kachurovskiy/modulathe/v2/freecad/Toolpost60.FCStd

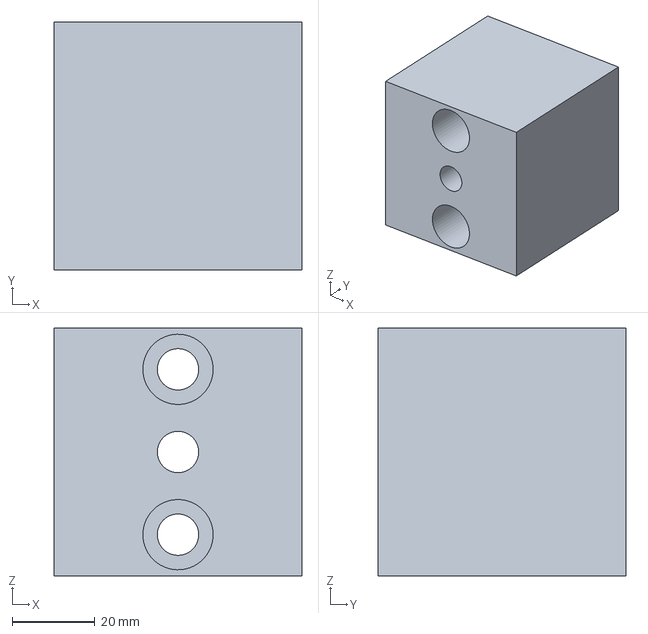
[picture p1: CAD file, 2025-09-17]
v2/freecad/Toolpost60.FCStd
60.0 x 60.0 x 60.0 mm
