kachurovskiy/modulathe/v2/step/MiddlePlateGuard2.step

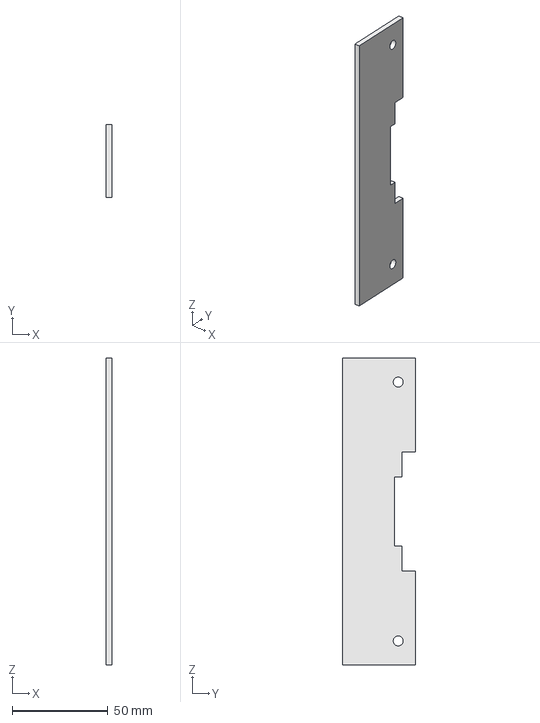
[picture p2: CAD file, 2025-09-17]
v2/step/MiddlePlateGuard2.step
3.00 x 38.0 x 160.0 mm
