kachurovskiy/modulathe/v2/freecad/DFU1605Nut.FCStd

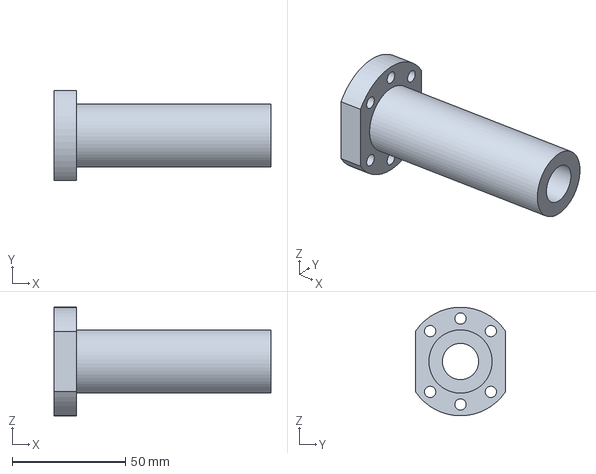
[picture p3: CAD file, 2025-09-17]
v2/freecad/DFU1605Nut.FCStd
96.0 x 40.0 x 48.0 mm
