kachurovskiy/modulathe/v2/step/Handwheels-Mount.step

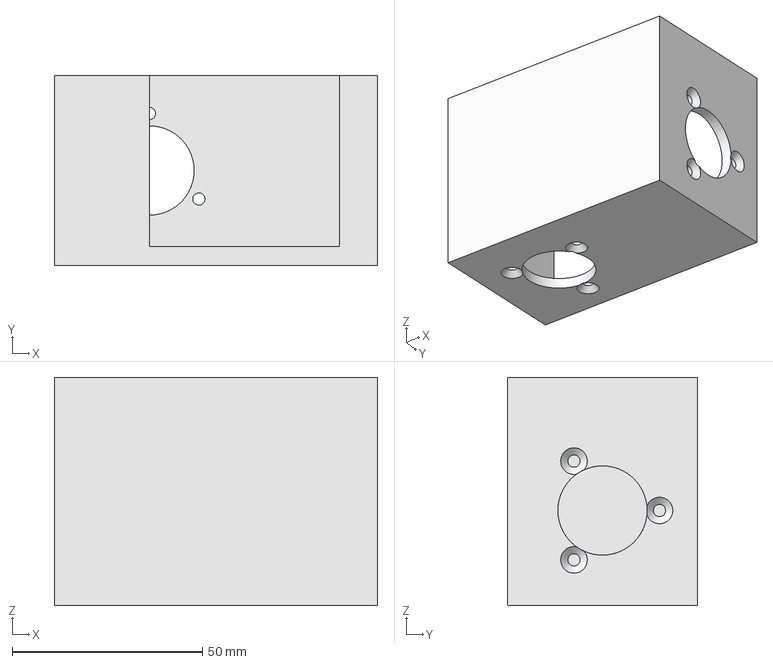
[picture p4: CAD file, 2025-09-17]
v2/step/Handwheels-Mount.step
85.0 x 50.0 x 60.0 mm
