kachurovskiy/modulathe/v2/freecad/3210B-2RS.FCStd

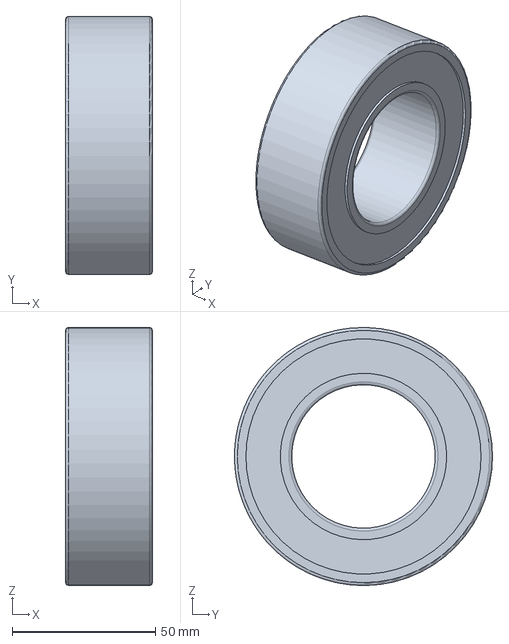
[picture p5: CAD file, 2025-09-17]
v2/freecad/3210B-2RS.FCStd
30.2 x 90.0 x 90.0 mm
