kachurovskiy/modulathe/v2/step/Motor1100BeltCover.step

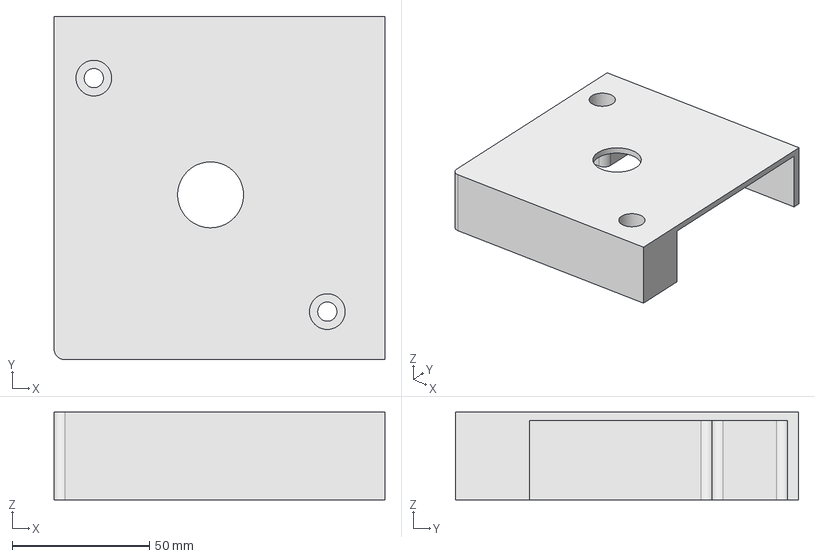
[picture p6: CAD file, 2025-09-17]
v2/step/Motor1100BeltCover.step
120.5 x 125.0 x 32.0 mm
