kachurovskiy/modulathe/v2/freecad/H5Mount.FCStd

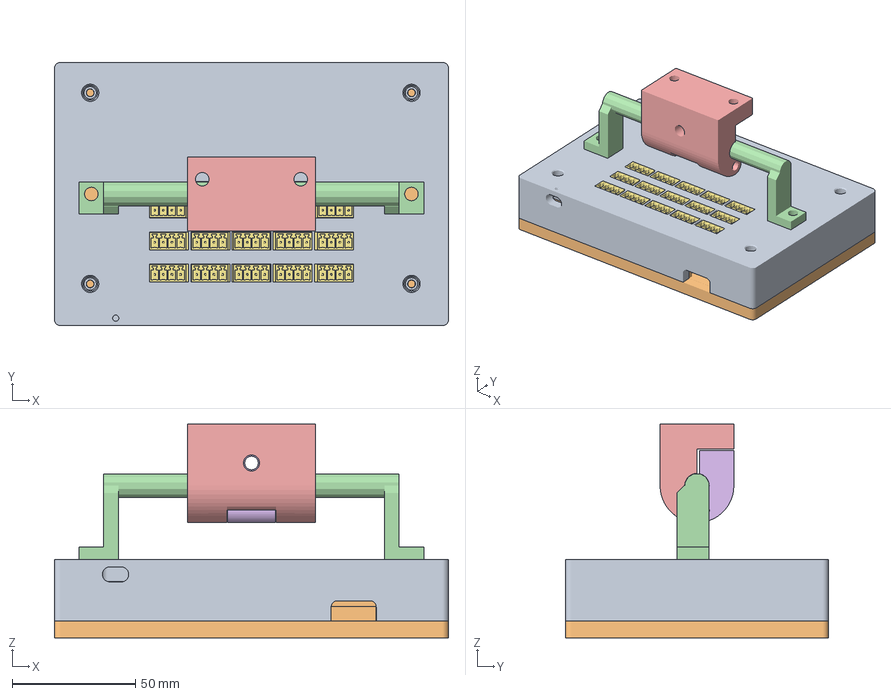
[picture p7: CAD file, 2025-09-17]
v2/freecad/H5Mount.FCStd
160.0 x 107.0 x 86.8 mm
h5case
NX8048P050-011C
esp32-wroom-1
h5handle
h5mount1
h5mount2
pcb
