kachurovskiy/modulathe/v2/step/MiddlePlateBellow2.step

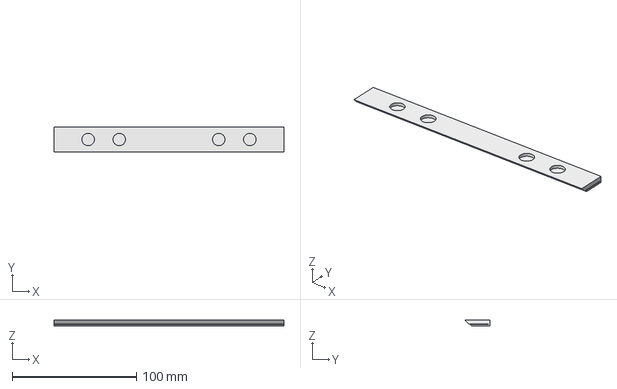
[picture p8: CAD file, 2025-09-17]
v2/step/MiddlePlateBellow2.step
185.0 x 20.0 x 4.50 mm
