kachurovskiy/modulathe/v2/freecad/Tailstock100.FCStd

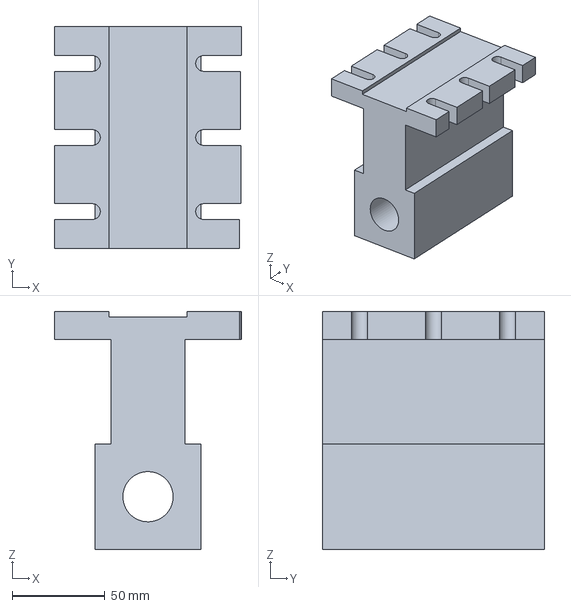
[picture p9: CAD file, 2025-09-17]
v2/freecad/Tailstock100.FCStd
101.0 x 120.0 x 128.5 mm
