kachurovskiy/modulathe/v2/step/Handwheels-Handwheel.step

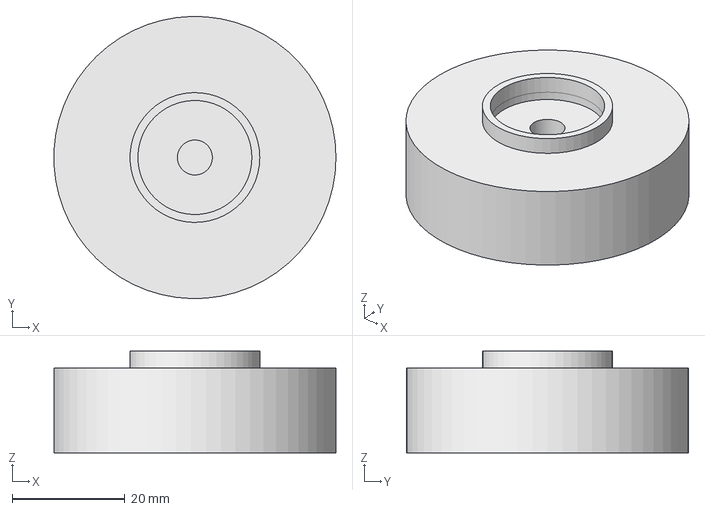
[picture p10: CAD file, 2025-09-17]
v2/step/Handwheels-Handwheel.step
50.0 x 50.0 x 18.0 mm
