kachurovskiy/modulathe/v2/freecad/Handwheels.FCStd

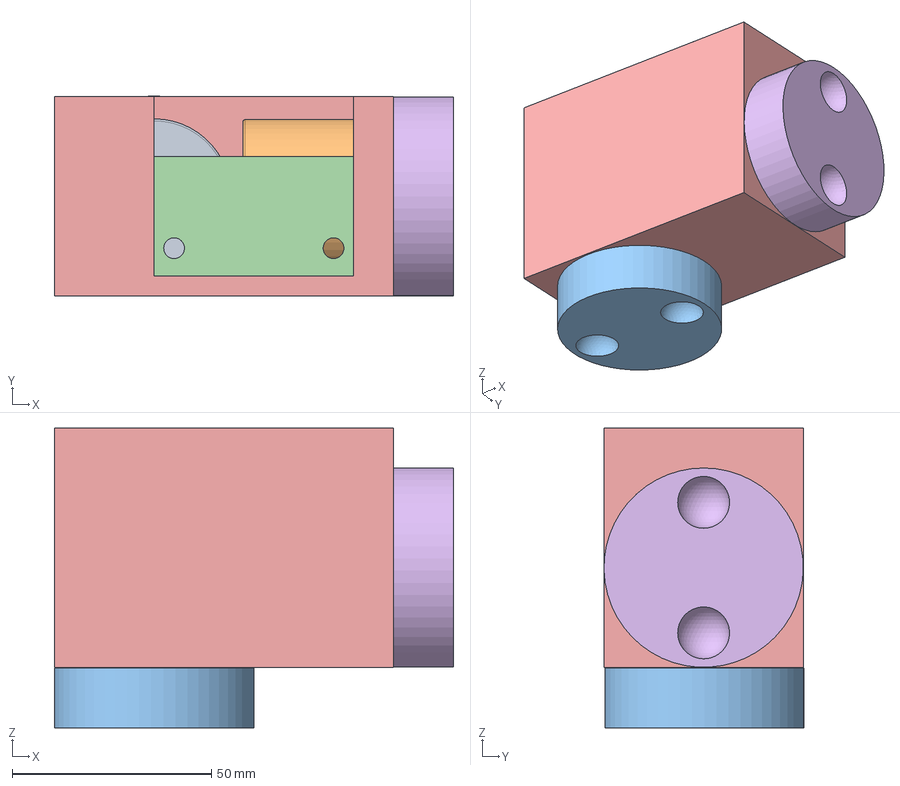
[picture p11: CAD file, 2025-09-17]
v2/freecad/Handwheels.FCStd
100.1 x 50.2 x 75.2 mm
Encoder
Encoder001
Handwheel
Base
Mount
Handwheel001
