kachurovskiy/modulathe/v2/step/MiddlePlateBellow3.step

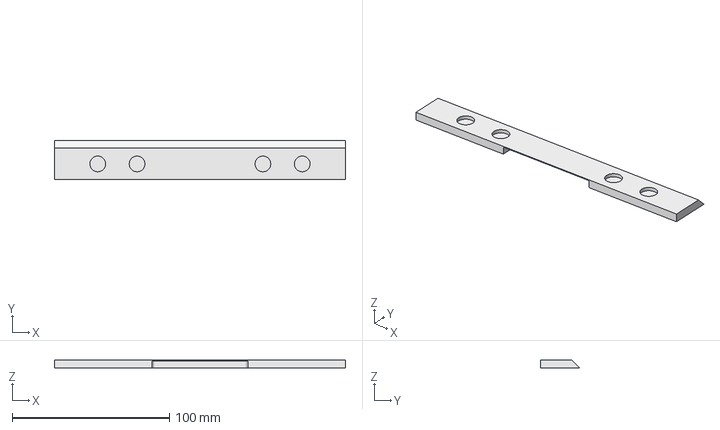
[picture p12: CAD file, 2025-09-17]
v2/step/MiddlePlateBellow3.step
185.0 x 25.0 x 5.00 mm
