kachurovskiy/modulathe/v2/freecad/DSG16H.FCStd

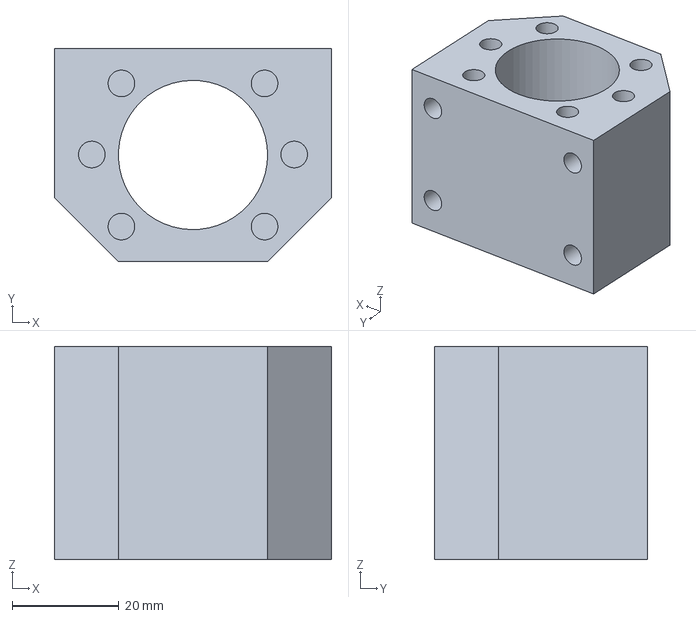
[picture p13: CAD file, 2025-09-17]
v2/freecad/DSG16H.FCStd
52.0 x 40.0 x 40.0 mm
