kachurovskiy/modulathe/v2/freecad/EncoderBelt6GT3.FCStd

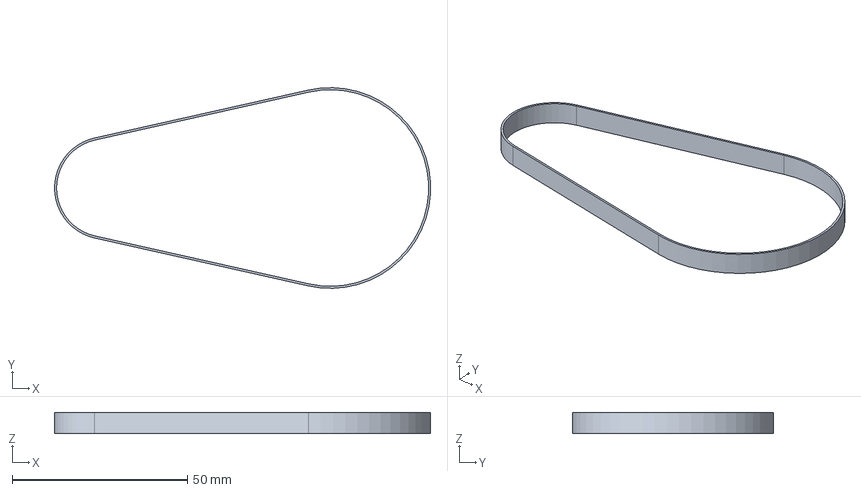
[picture p14: CAD file, 2025-09-17]
v2/freecad/EncoderBelt6GT3.FCStd
107.1 x 57.2 x 6.00 mm
