kachurovskiy/modulathe/v2/step/CabinetLid.step

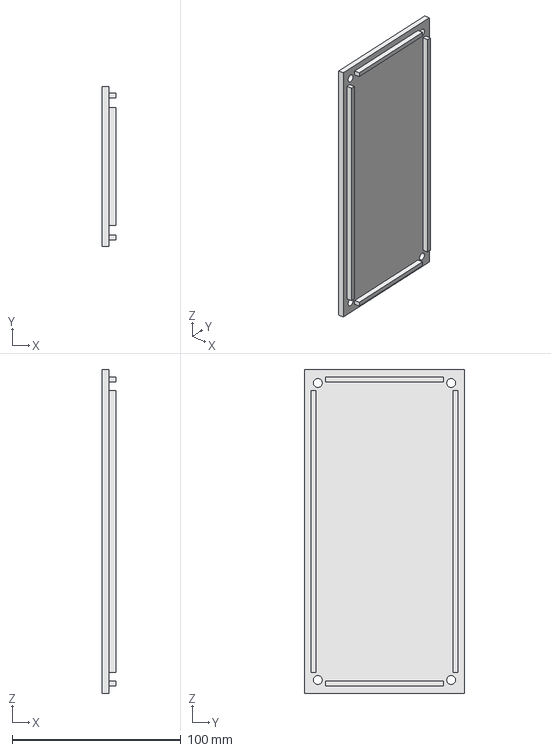
[picture p15: CAD file, 2025-09-17]
v2/step/CabinetLid.step
8.00 x 95.0 x 192.0 mm
