kachurovskiy/modulathe/v2/freecad/3209B-2RS.FCStd

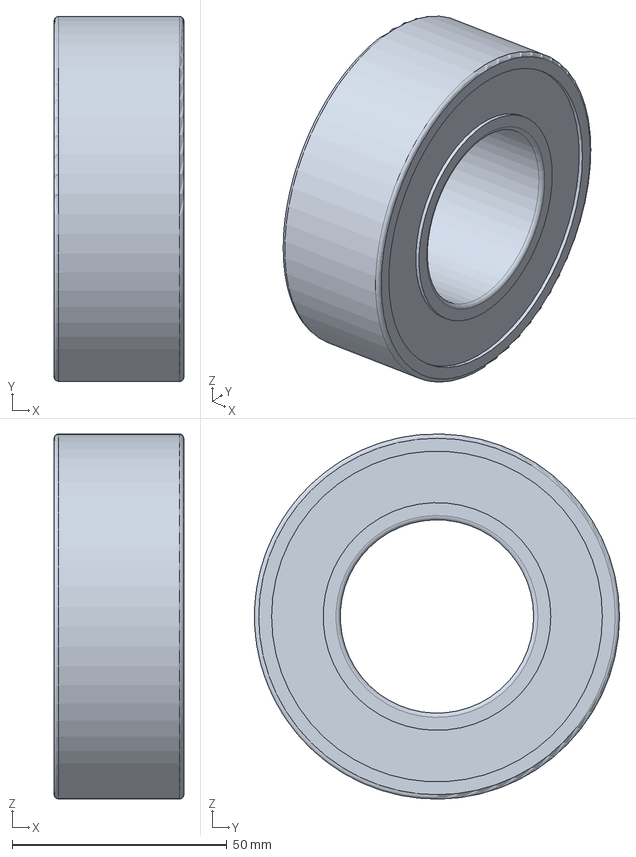
[picture p16: CAD file, 2025-09-17]
v2/freecad/3209B-2RS.FCStd
30.2 x 85.0 x 85.0 mm
