kachurovskiy/modulathe/v2/step/TopPlateGuardShort1.step

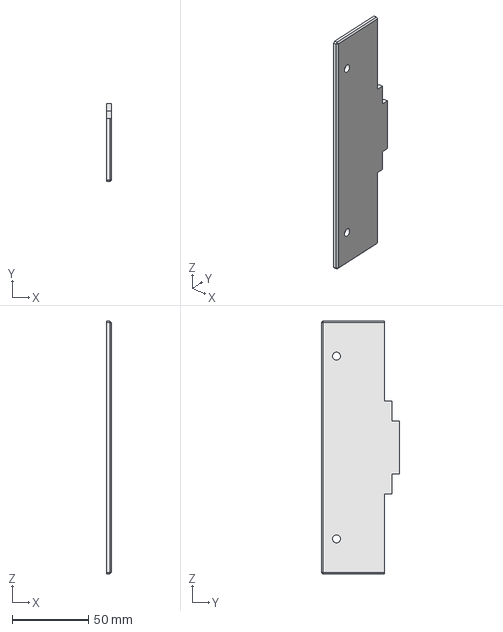
[picture p17: CAD file, 2025-09-17]
v2/step/TopPlateGuardShort1.step
3.00 x 51.5 x 166.0 mm
