kachurovskiy/modulathe/v2/freecad/HGH20CA.FCStd

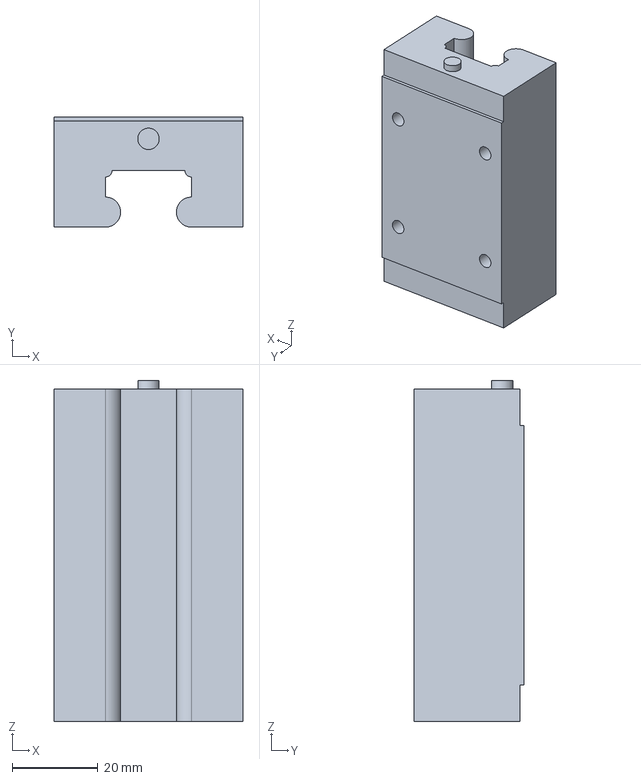
[picture p18: CAD file, 2025-09-17]
v2/freecad/HGH20CA.FCStd
44.0 x 25.7 x 79.5 mm
