kachurovskiy/modulathe/v2/step/MotorPulley30GT3.step

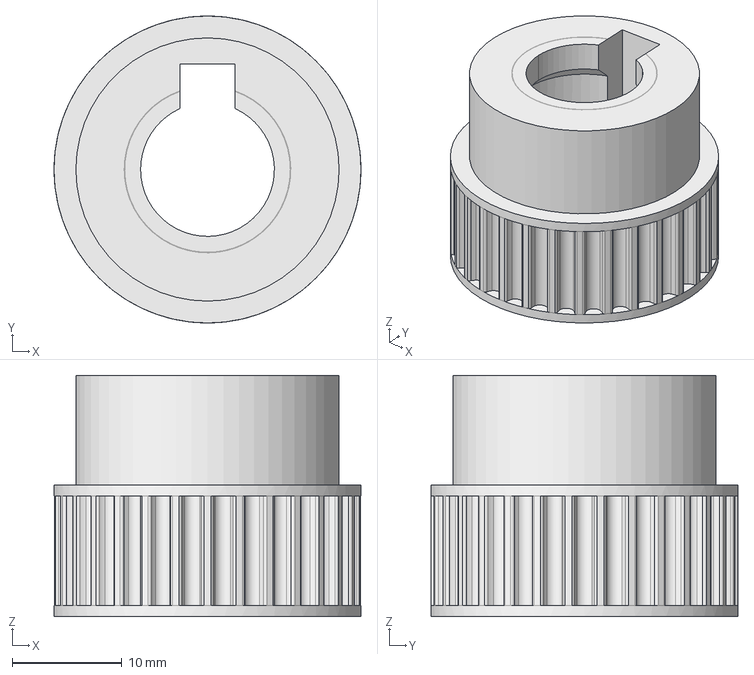
[picture p19: CAD file, 2025-09-17]
v2/step/MotorPulley30GT3.step
28.0 x 28.0 x 22.0 mm
