kachurovskiy/modulathe/v2/freecad/Track30-400.FCStd

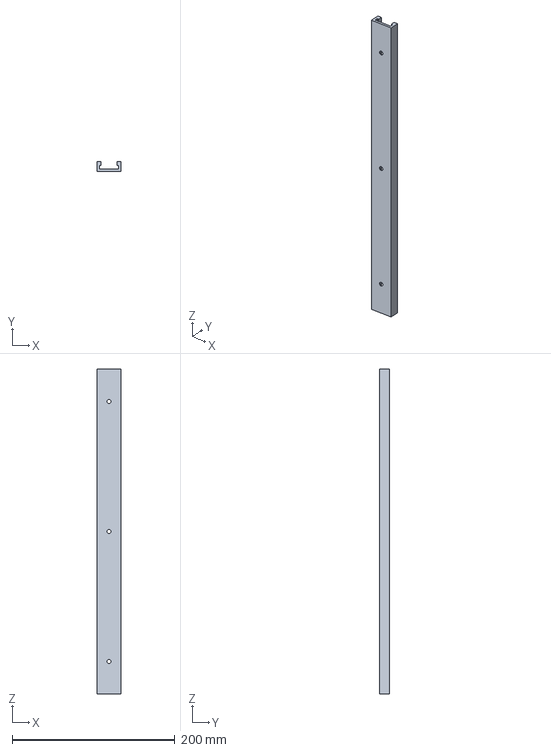
[picture p20: CAD file, 2025-09-17]
v2/freecad/Track30-400.FCStd
30.0 x 12.8 x 400.0 mm
