kachurovskiy/modulathe/v2/step/EncoderMount.step

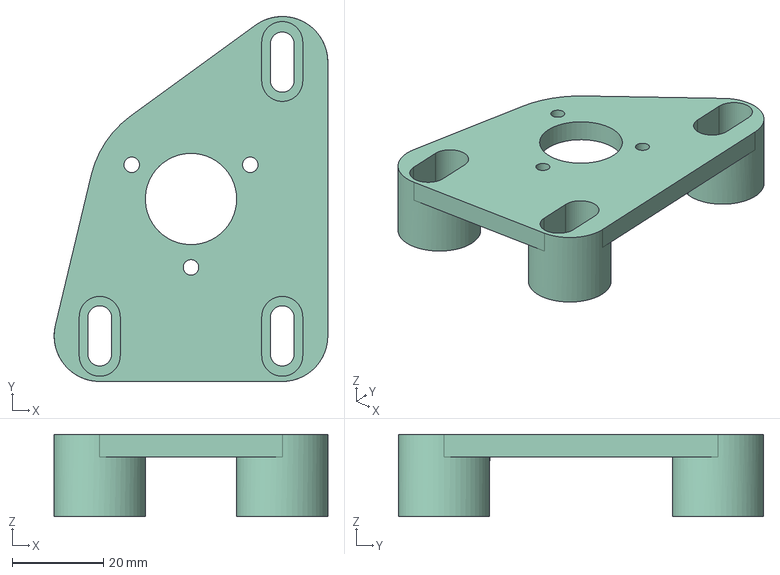
[picture p21: CAD file, 2025-09-17]
v2/step/EncoderMount.step
60.0 x 80.0 x 18.0 mm
