kachurovskiy/modulathe/v2/freecad/Coupler25-20-8-10.FCStd

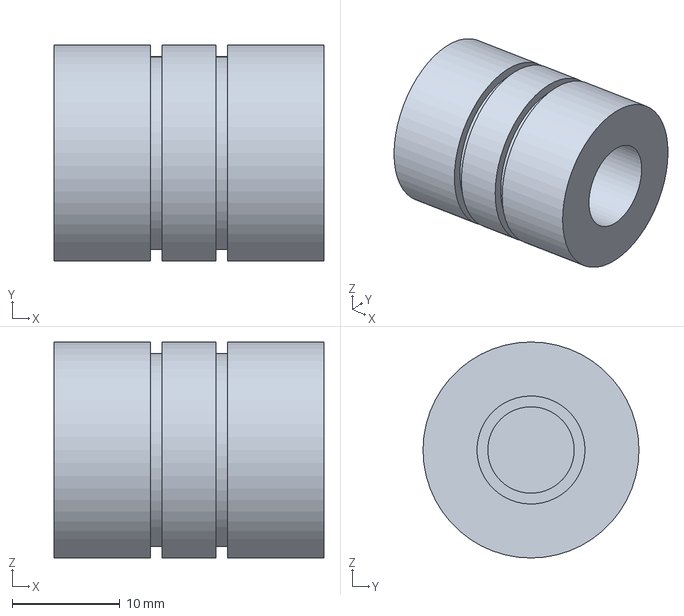
[picture p22: CAD file, 2025-09-17]
v2/freecad/Coupler25-20-8-10.FCStd
25.0 x 20.0 x 20.0 mm
