kachurovskiy/modulathe/v2/freecad/HGR15-300.FCStd

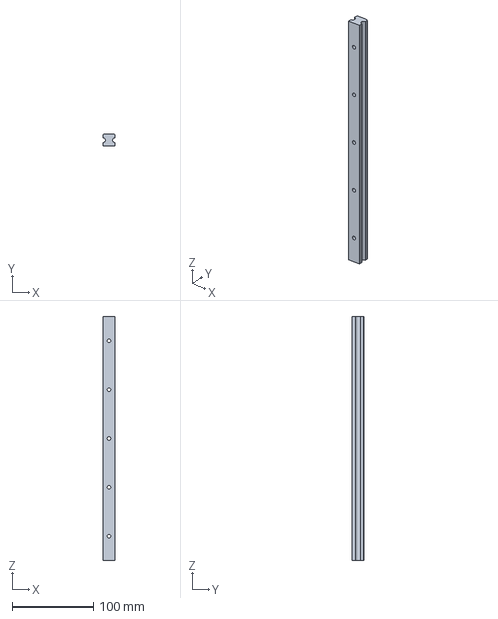
[picture p23: CAD file, 2025-09-17]
v2/freecad/HGR15-300.FCStd
15.0 x 15.0 x 300.0 mm
