kachurovskiy/modulathe/v2/step/H5Mount-h5mount1.step

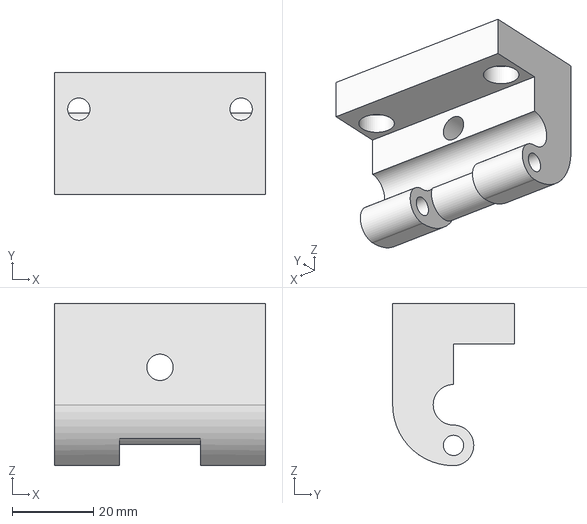
[picture p24: CAD file, 2025-09-17]
v2/step/H5Mount-h5mount1.step
52.0 x 30.0 x 40.0 mm
