kachurovskiy/modulathe/v2/freecad/BF12.FCStd

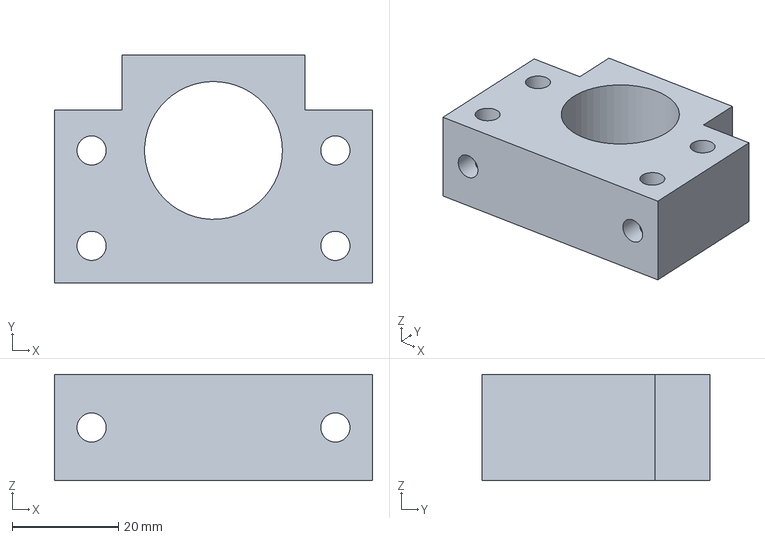
[picture p25: CAD file, 2025-09-17]
v2/freecad/BF12.FCStd
60.0 x 43.0 x 20.0 mm
