kachurovskiy/modulathe/v2/step/Handwheels-Base.step

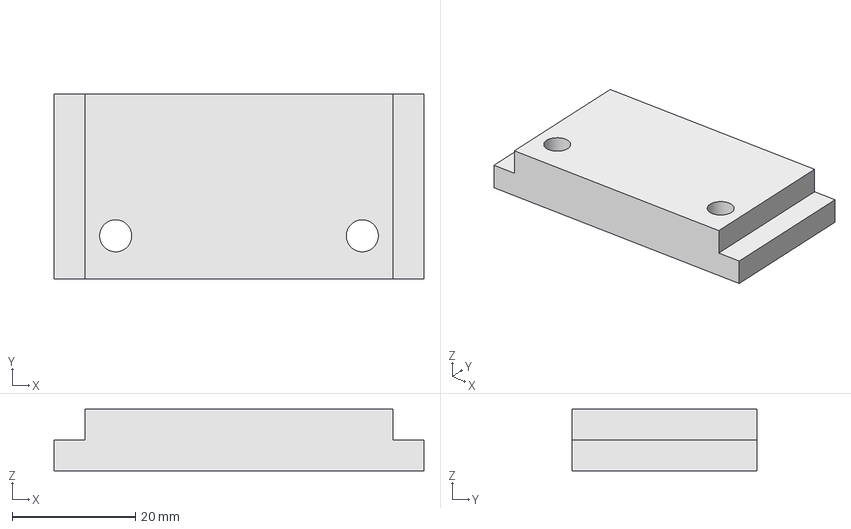
[picture p26: CAD file, 2025-09-17]
v2/step/Handwheels-Base.step
60.0 x 30.0 x 10.0 mm
