kachurovskiy/modulathe/v2/freecad/DFU1605-600.FCStd

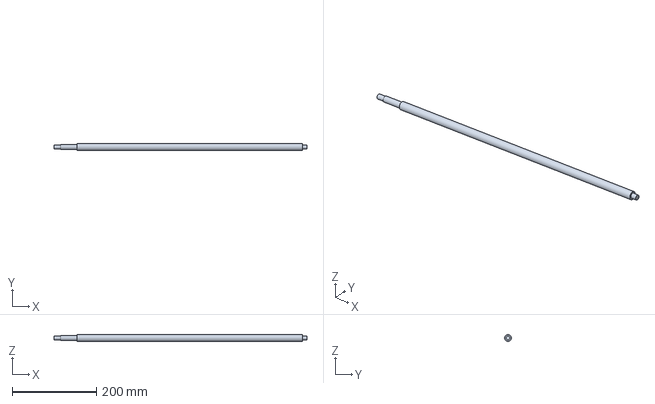
[picture p27: CAD file, 2025-09-17]
v2/freecad/DFU1605-600.FCStd
600.0 x 16.0 x 16.0 mm
