kachurovskiy/modulathe/v2/step/H5Mount-h5handle.step

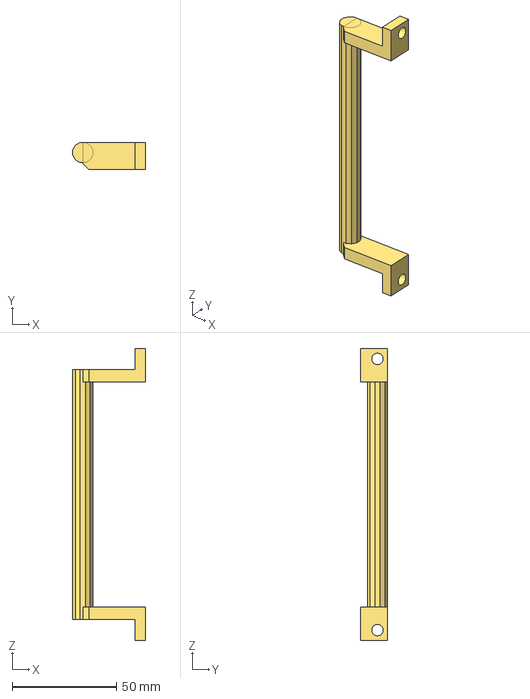
[picture p28: CAD file, 2025-09-17]
v2/step/H5Mount-h5handle.step
34.8 x 13.0 x 140.0 mm
