kachurovskiy/modulathe/v2/freecad/HGR20-600.FCStd

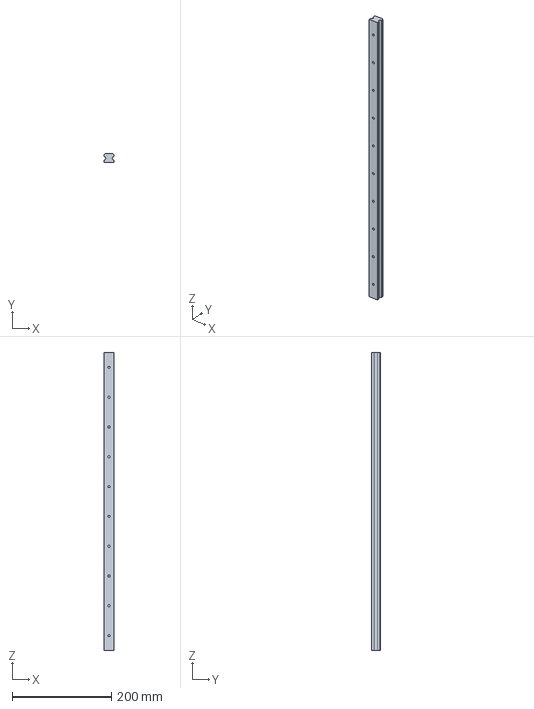
[picture p29: CAD file, 2025-09-17]
v2/freecad/HGR20-600.FCStd
20.0 x 17.5 x 600.0 mm
