kachurovskiy/modulathe/v2/step/H5Mount-h5mount2.step

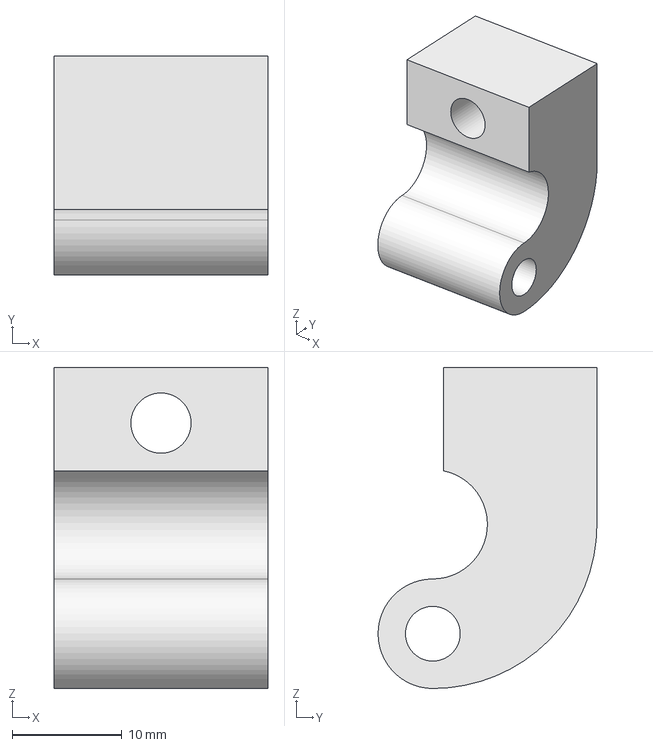
[picture p30: CAD file, 2025-09-17]
v2/step/H5Mount-h5mount2.step
19.5 x 20.0 x 29.3 mm
