kachurovskiy/modulathe/v2/freecad/BallNut1204.FCStd

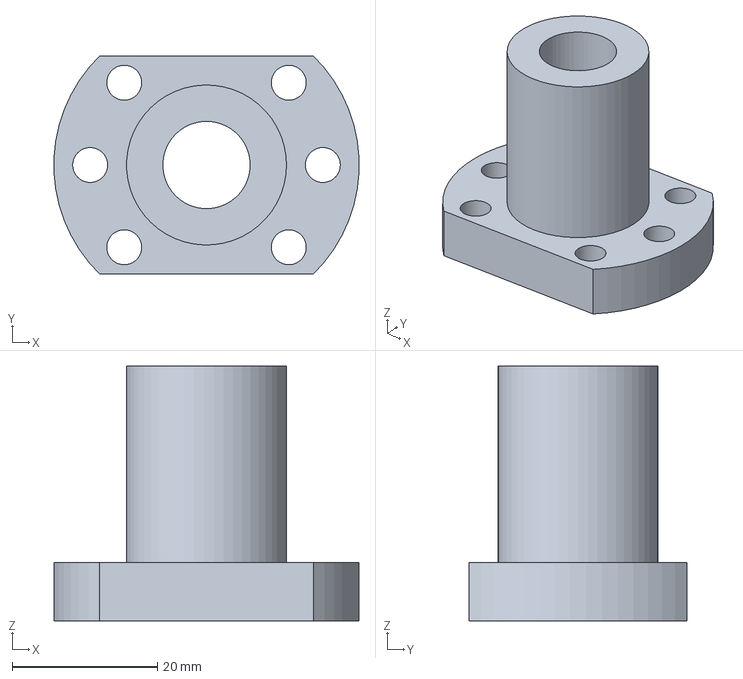
[picture p31: CAD file, 2025-09-17]
v2/freecad/BallNut1204.FCStd
41.9 x 30.0 x 35.0 mm
