kachurovskiy/modulathe/v2/step/EncoderGearGT3-30.step

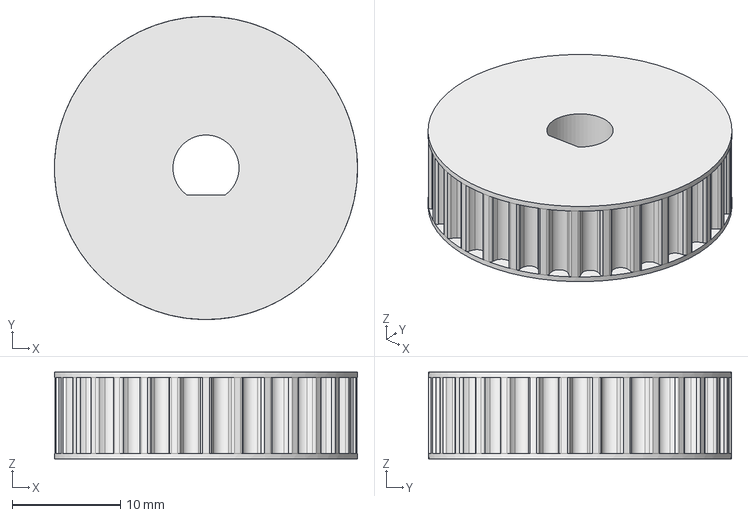
[picture p32: CAD file, 2025-09-17]
v2/step/EncoderGearGT3-30.step
28.0 x 28.0 x 8.00 mm
