kachurovskiy/modulathe/v2/freecad/HGW15CC.FCStd

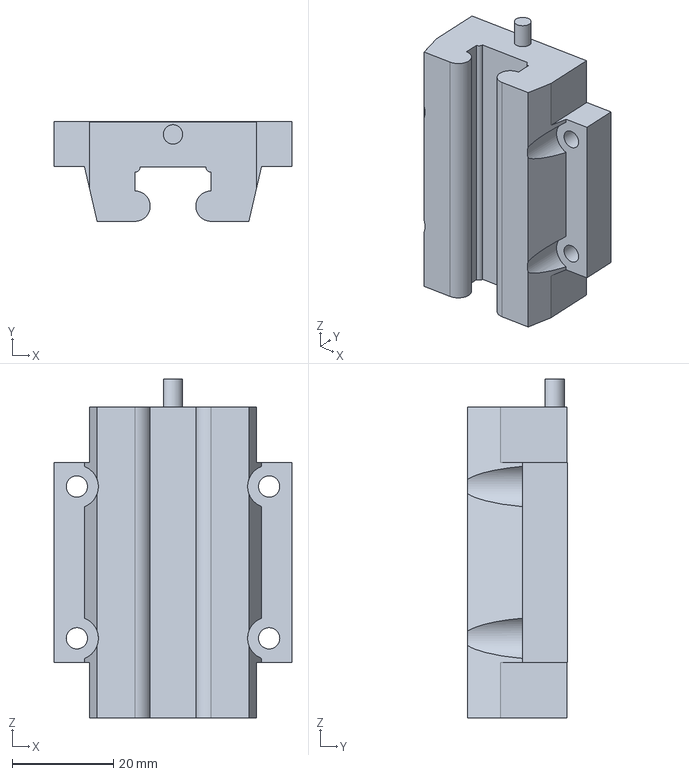
[picture p33: CAD file, 2025-09-17]
v2/freecad/HGW15CC.FCStd
47.0 x 19.7 x 67.0 mm
