kachurovskiy/modulathe/v2/step/TopPlateGuardLong1.step

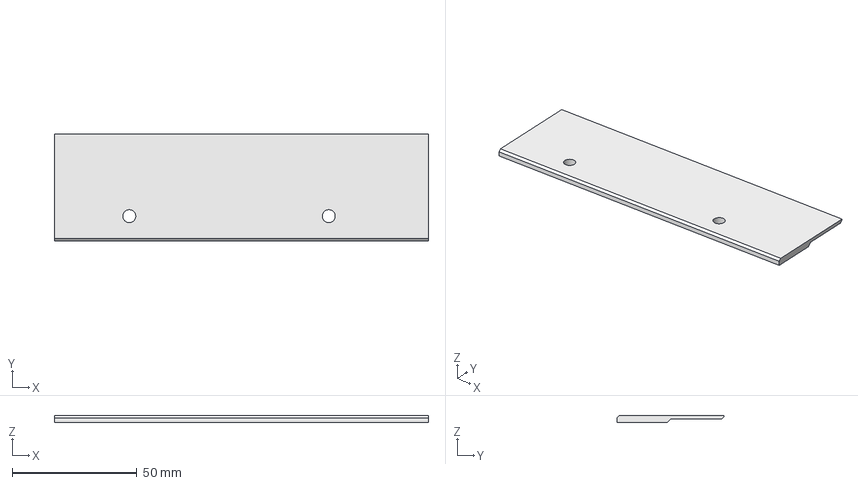
[picture p34: CAD file, 2025-09-17]
v2/step/TopPlateGuardLong1.step
150.0 x 43.0 x 3.00 mm
