kachurovskiy/modulathe/v2/freecad/SFU1204-300.FCStd

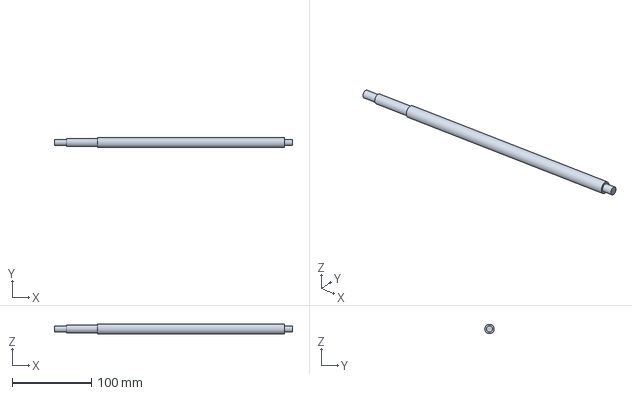
[picture p35: CAD file, 2025-09-17]
v2/freecad/SFU1204-300.FCStd
300.0 x 12.0 x 12.0 mm
