kachurovskiy/modulathe/v2/step/TopPlateGuardShort2.step

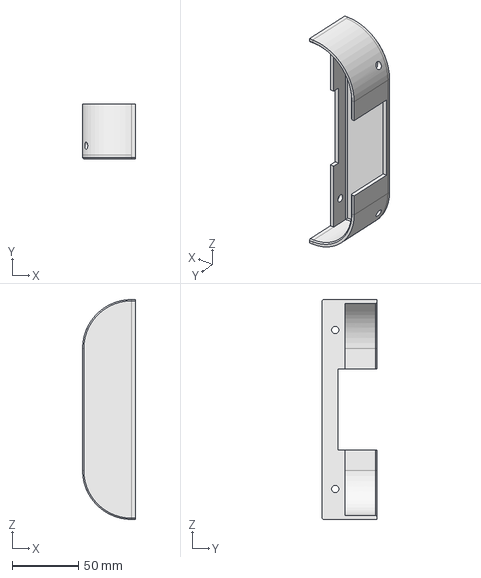
[picture p36: CAD file, 2025-09-17]
v2/step/TopPlateGuardShort2.step
40.0 x 41.5 x 166.0 mm
