kachurovskiy/modulathe/v2/step/RearStop.step

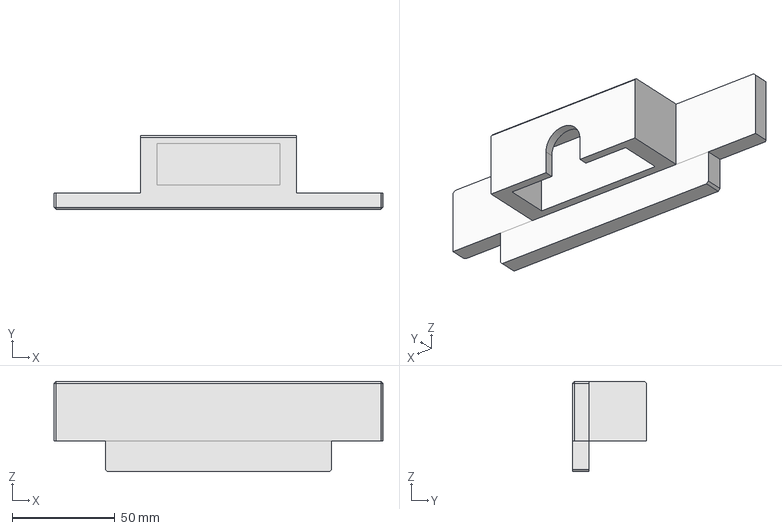
[picture p37: CAD file, 2025-09-17]
v2/step/RearStop.step
160.0 x 36.0 x 44.0 mm
