kachurovskiy/modulathe/v2/freecad/M12Nut.FCStd

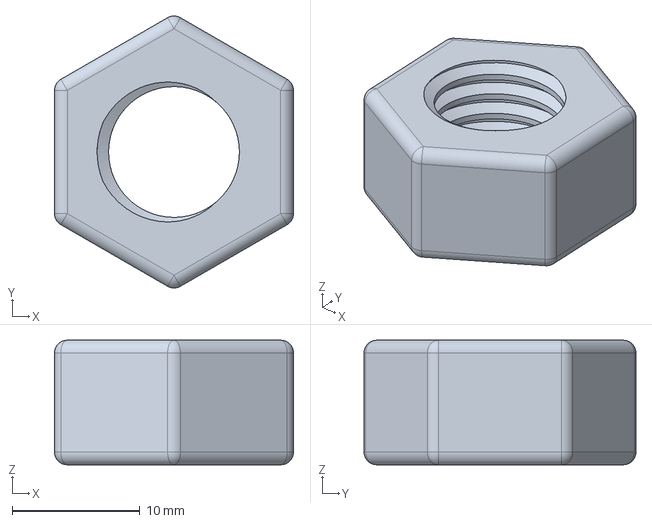
[picture p38: CAD file, 2025-09-17]
v2/freecad/M12Nut.FCStd
18.7 x 21.3 x 9.75 mm
