kachurovskiy/modulathe/v2/step/SpindleGear60GT3.step

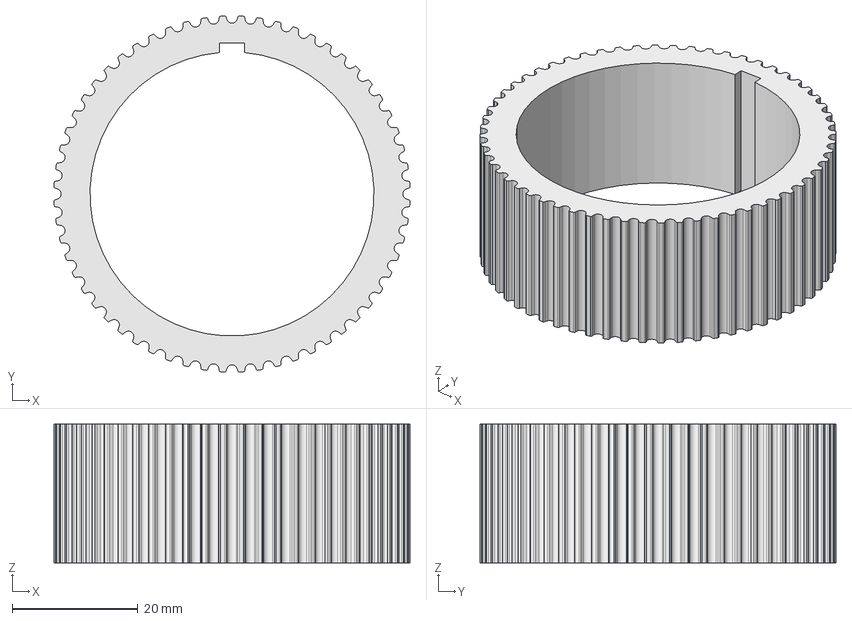
[picture p39: CAD file, 2025-09-17]
v2/step/SpindleGear60GT3.step
56.5 x 56.5 x 22.0 mm
