kachurovskiy/modulathe/v2/freecad/ZMotorMount.FCStd

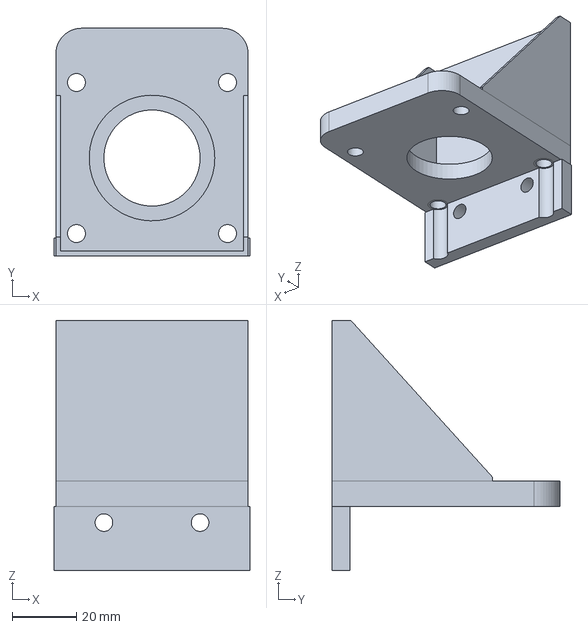
[picture p40: CAD file, 2025-09-17]
v2/freecad/ZMotorMount.FCStd
61.0 x 71.0 x 78.0 mm
