kachurovskiy/modulathe/v2/freecad/HM10-57.FCStd

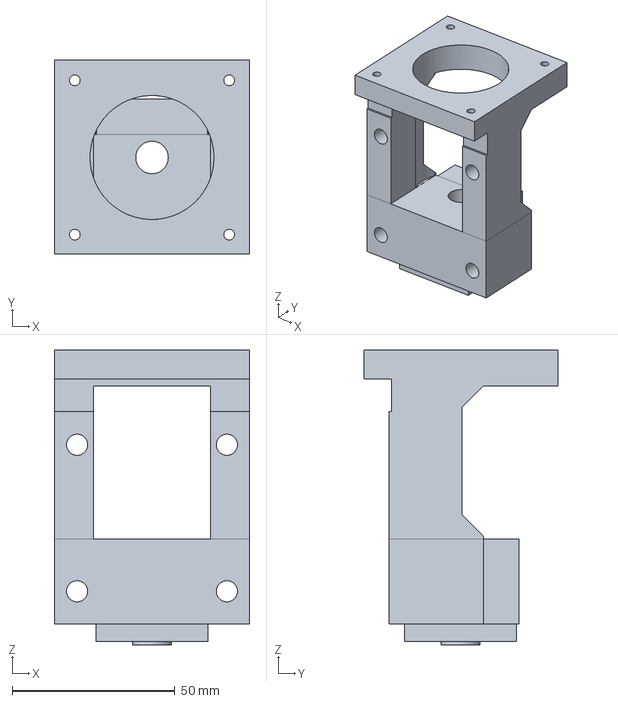
[picture p41: CAD file, 2025-09-17]
v2/freecad/HM10-57.FCStd
60.0 x 59.5 x 90.6 mm
