kachurovskiy/modulathe/v2/step/Cabinet.step

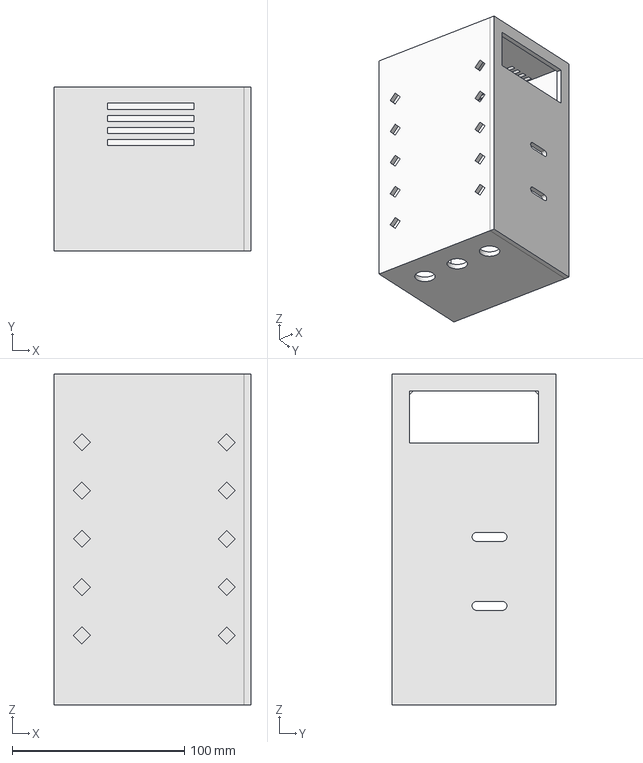
[picture p42: CAD file, 2025-09-17]
v2/step/Cabinet.step
114.0 x 95.0 x 192.0 mm
