kachurovskiy/modulathe/v2/freecad/BK12Axial.FCStd

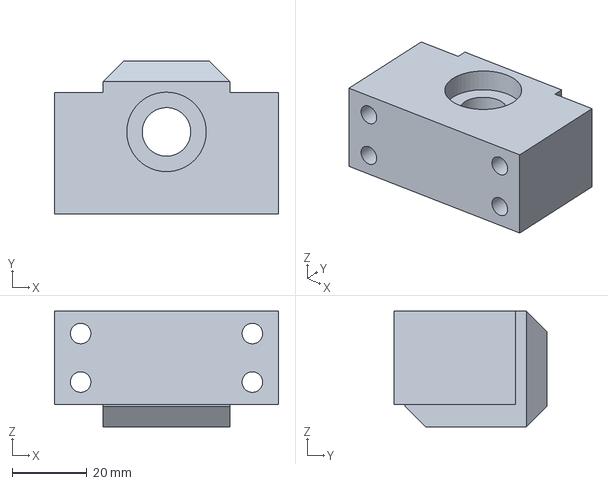
[picture p43: CAD file, 2025-09-17]
v2/freecad/BK12Axial.FCStd
60.0 x 41.0 x 31.0 mm
