kachurovskiy/modulathe/v2/step/EngineCover.step

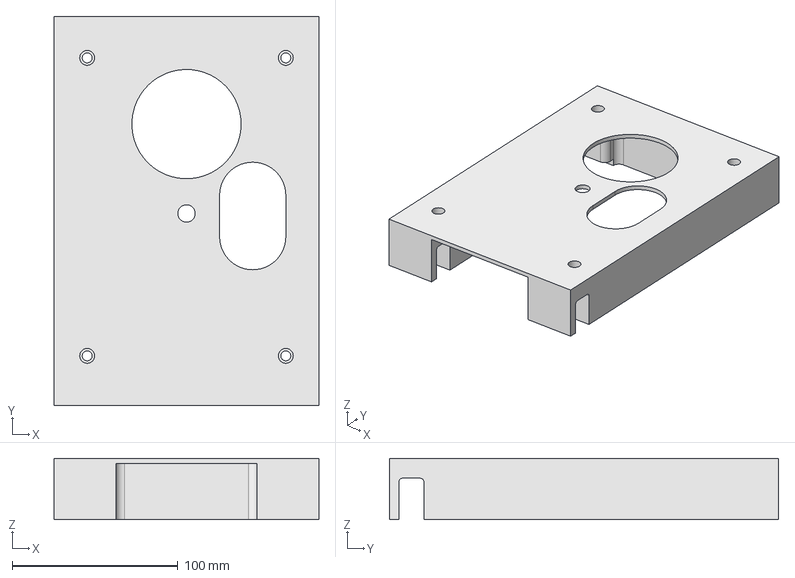
[picture p44: CAD file, 2025-09-17]
v2/step/EngineCover.step
160.0 x 235.0 x 37.0 mm
