kachurovskiy/modulathe/v2/freecad/Motor1100w.FCStd

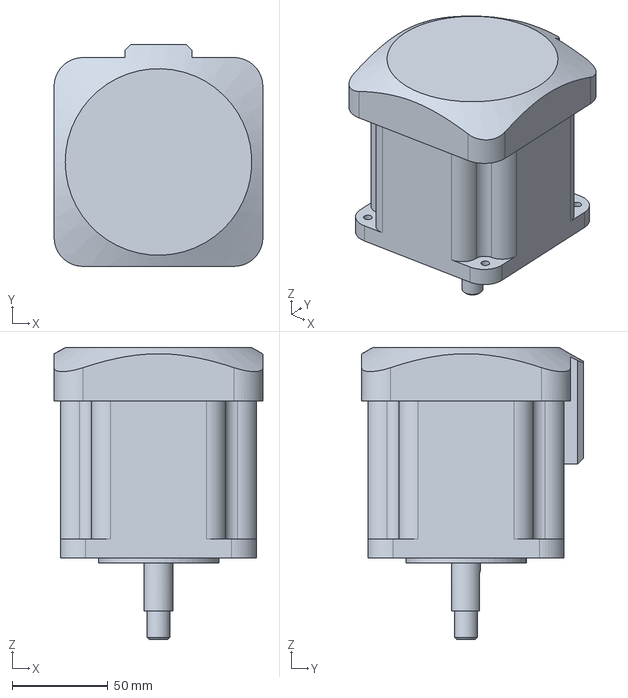
[picture p45: CAD file, 2025-09-17]
v2/freecad/Motor1100w.FCStd
109.0 x 115.8 x 152.5 mm
