kachurovskiy/modulathe/v2/step/MiddlePlateBellow1.step

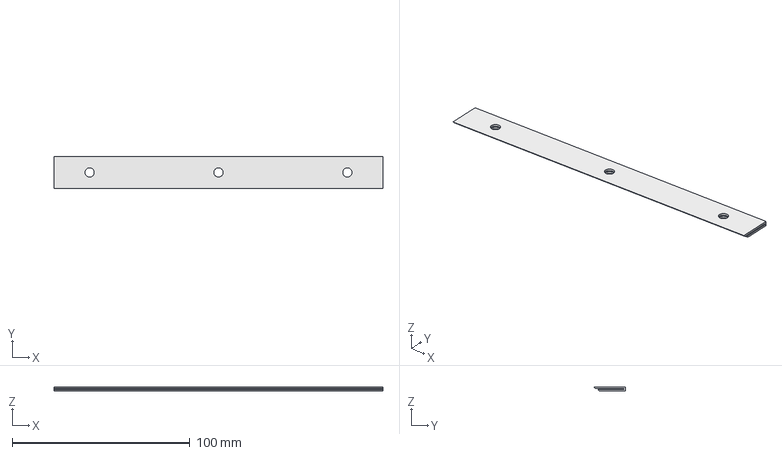
[picture p46: CAD file, 2025-09-17]
v2/step/MiddlePlateBellow1.step
185.0 x 18.0 x 2.50 mm
