kachurovskiy/modulathe/v2/freecad/ToolParting20.FCStd

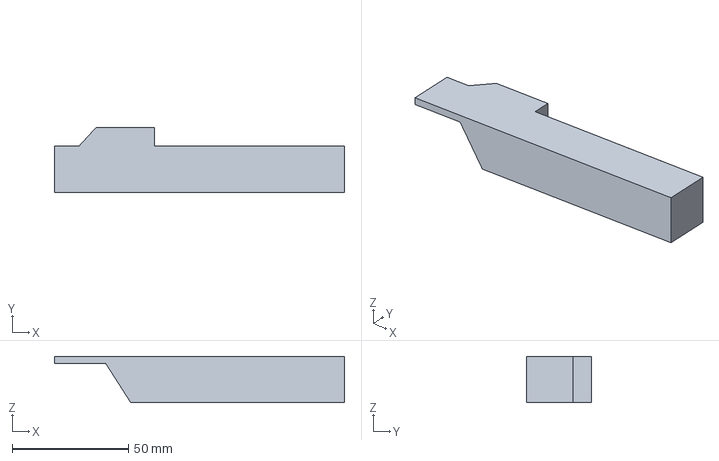
[picture p47: CAD file, 2025-09-17]
v2/freecad/ToolParting20.FCStd
125.0 x 28.0 x 20.0 mm
