kachurovskiy/modulathe/v2/step/Motor1100Bracket.step

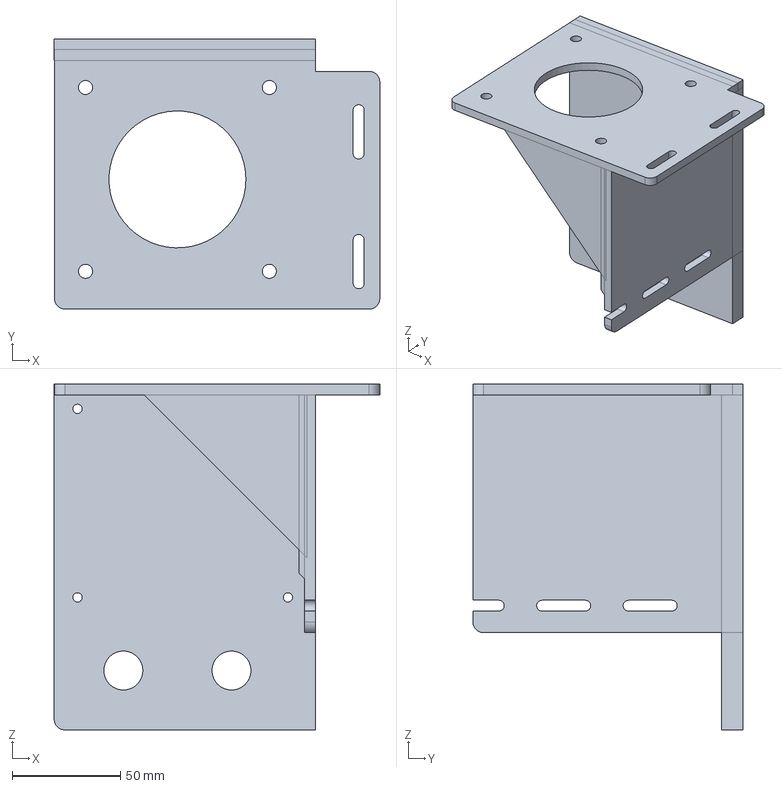
[picture p48: CAD file, 2025-09-17]
v2/step/Motor1100Bracket.step
150.6 x 125.0 x 160.0 mm
