kachurovskiy/modulathe/v2/freecad/BK12C5.FCStd

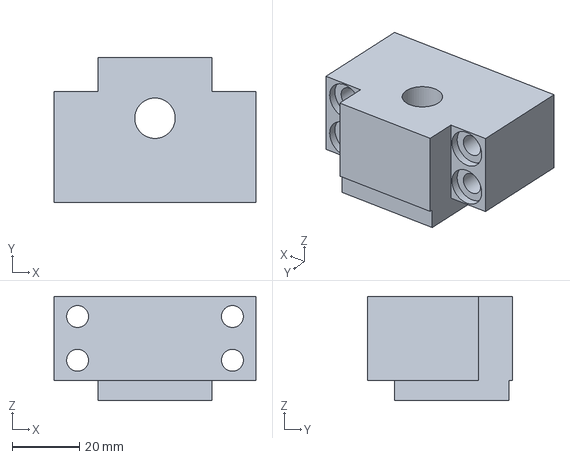
[picture p49: CAD file, 2025-09-17]
v2/freecad/BK12C5.FCStd
60.0 x 43.0 x 31.0 mm
