kachurovskiy/modulathe/v2/step/TailstockPlate-Mold.step

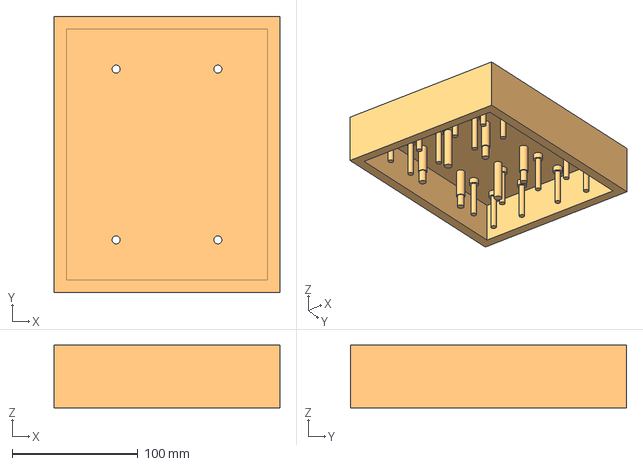
[picture p50: CAD file, 2025-07-10]
v2/step/TailstockPlate-Mold.step
180.0 x 220.0 x 50.0 mm
