kachurovskiy/modulathe/v2/freecad/Encoder38-6.FCStd

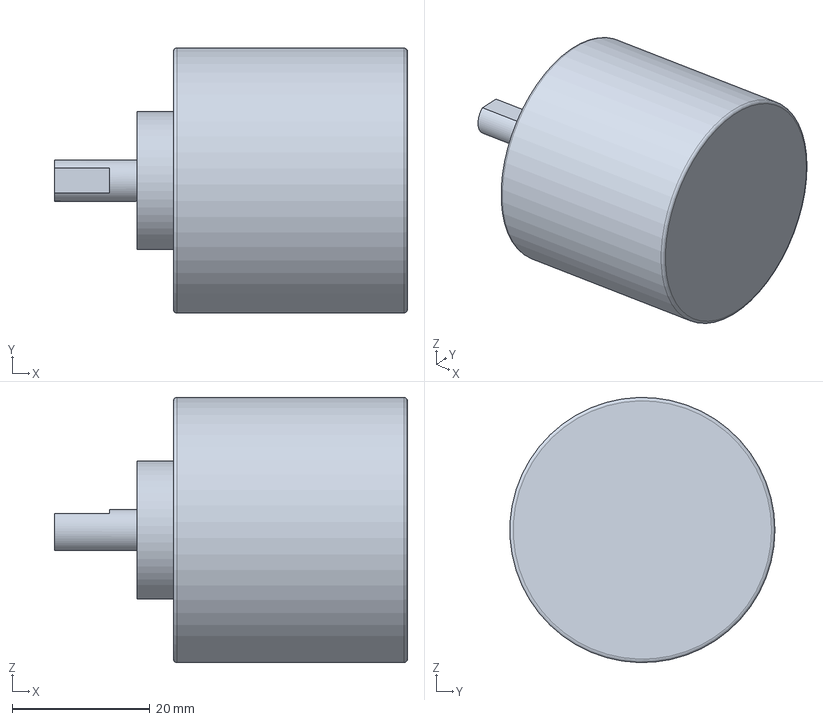
[picture p51: CAD file, 2025-09-17]
v2/freecad/Encoder38-6.FCStd
51.2 x 38.5 x 38.5 mm
