kachurovskiy/modulathe/v2/step/Toolpost60Simple.step

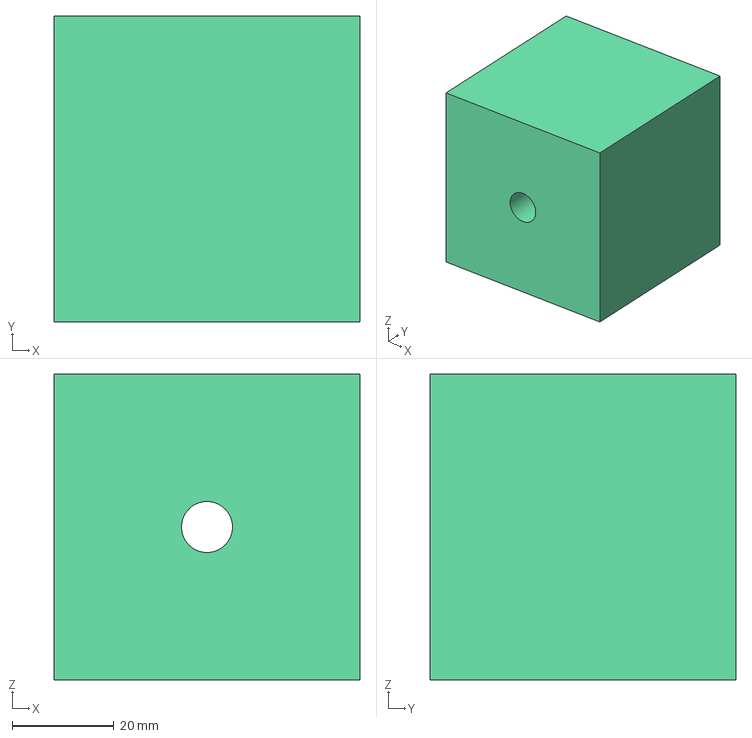
[picture p52: CAD file, 2025-07-10]
v2/step/Toolpost60Simple.step
60.0 x 60.0 x 60.0 mm
