kachurovskiy/modulathe/v2/freecad/NEMA23-100.FCStd

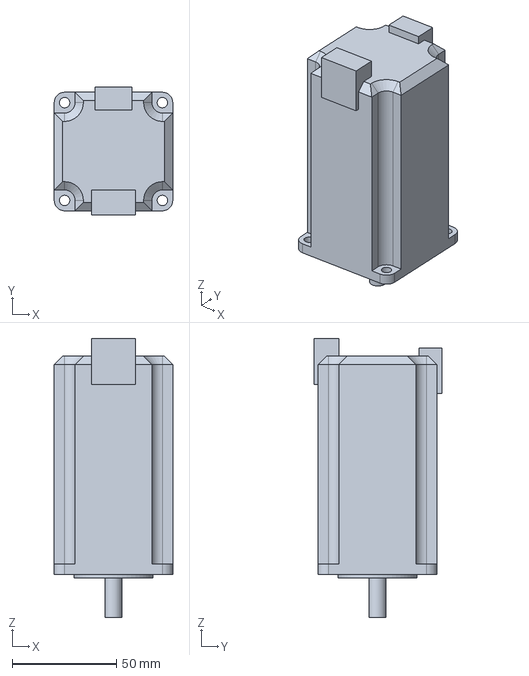
[picture p53: CAD file, 2025-09-17]
v2/freecad/NEMA23-100.FCStd
57.0 x 61.5 x 134.1 mm
