kachurovskiy/modulathe/v2/step/TopPlate.step

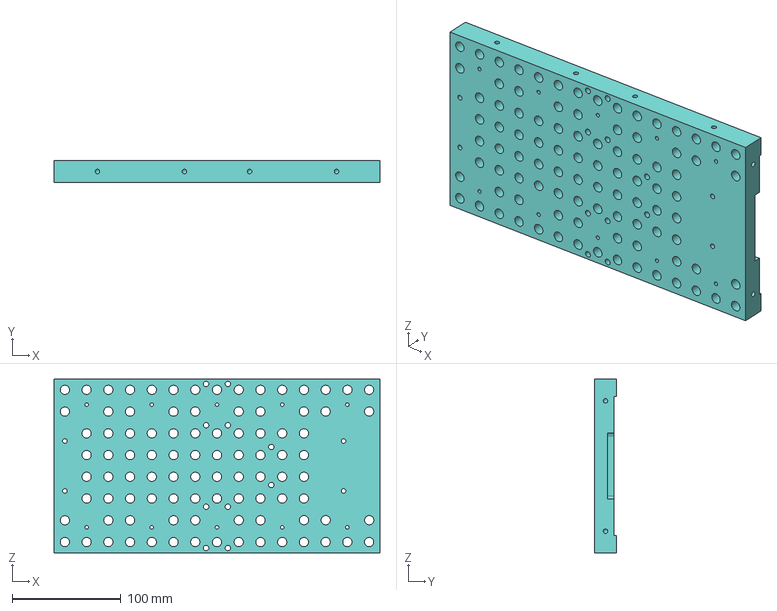
[picture p54: CAD file, 2025-07-10]
v2/step/TopPlate.step
300.0 x 20.0 x 160.0 mm
