kachurovskiy/modulathe/v2/freecad/BF10.FCStd

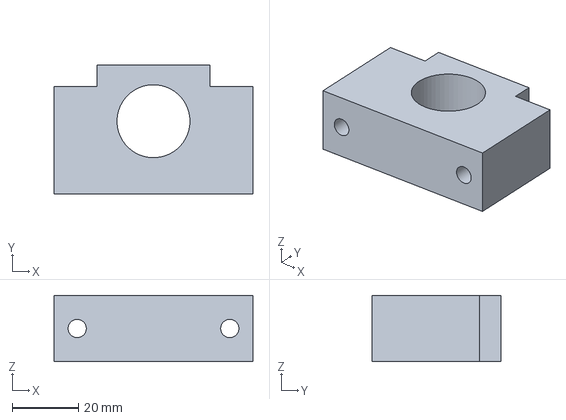
[picture p55: CAD file, 2025-09-17]
v2/freecad/BF10.FCStd
60.0 x 39.0 x 20.0 mm
