kachurovskiy/modulathe/v2/freecad/Spindle125-50-45.FCStd

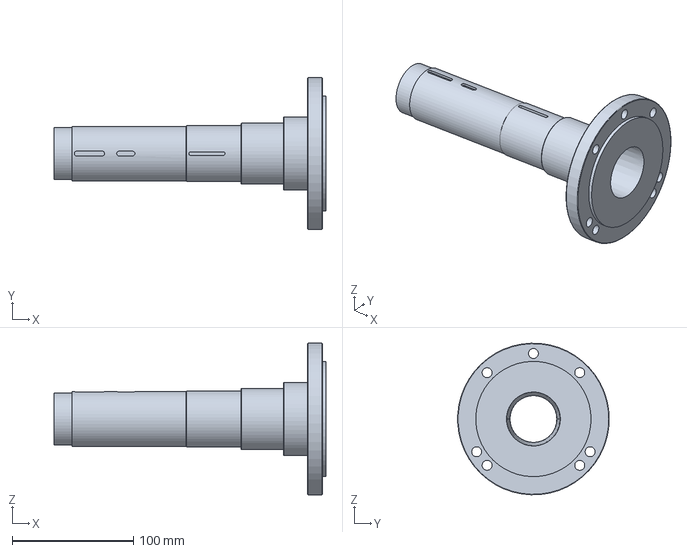
[picture p56: CAD file, 2025-09-17]
v2/freecad/Spindle125-50-45.FCStd
224.2 x 124.9 x 124.9 mm
