kachurovskiy/modulathe/v2/step/MiddlePlate.step

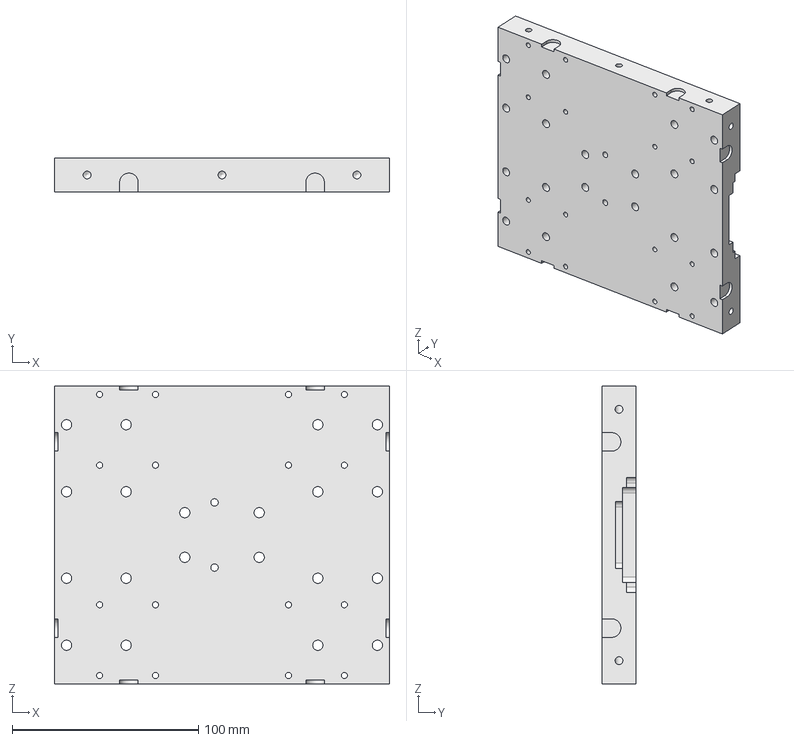
[picture p57: CAD file, 2025-07-10]
v2/step/MiddlePlate.step
180.0 x 18.0 x 160.0 mm
