kachurovskiy/modulathe/v2/step/TailstockPlate.step

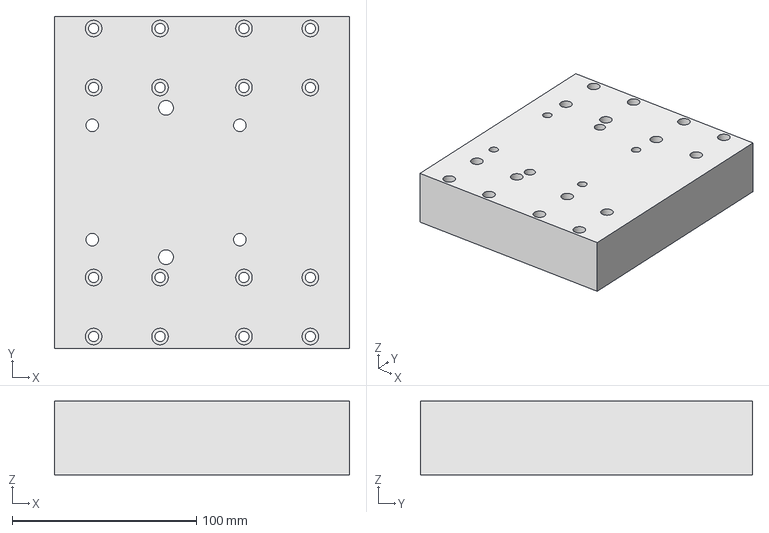
[picture p58: CAD file, 2025-07-10]
v2/step/TailstockPlate.step
160.0 x 180.0 x 40.0 mm
