kachurovskiy/modulathe/v2/freecad/BallNutMount2M5.FCStd

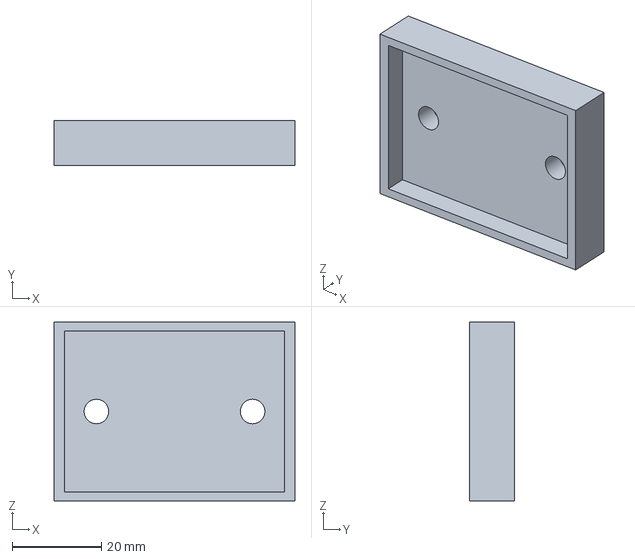
[picture p59: CAD file, 2025-07-10]
v2/freecad/BallNutMount2M5.FCStd
54.0 x 10.0 x 40.0 mm
