kachurovskiy/modulathe/v2/step/Head-Plate.step

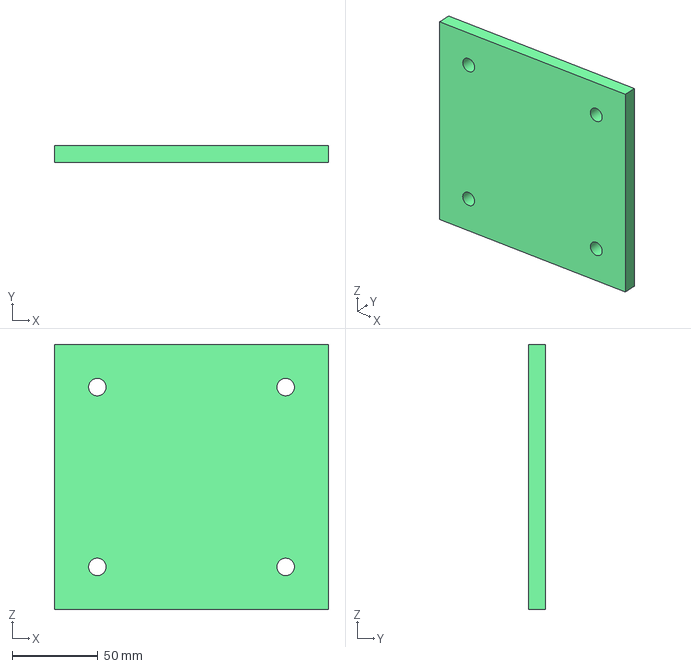
[picture p60: CAD file, 2025-04-12]
v2/step/Head-Plate.step
160.0 x 10.0 x 155.0 mm
