kachurovskiy/modulathe/v2/freecad/Head.FCStd

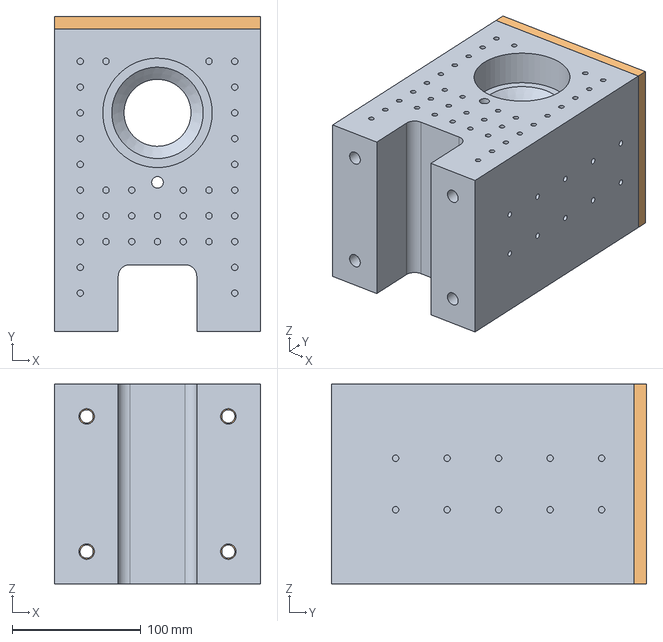
[picture p61: CAD file, 2025-04-12]
v2/freecad/Head.FCStd
160.0 x 245.0 x 155.0 mm
Head
Plate
