kachurovskiy/modulathe/v2/step/Head-MoldMotor.step

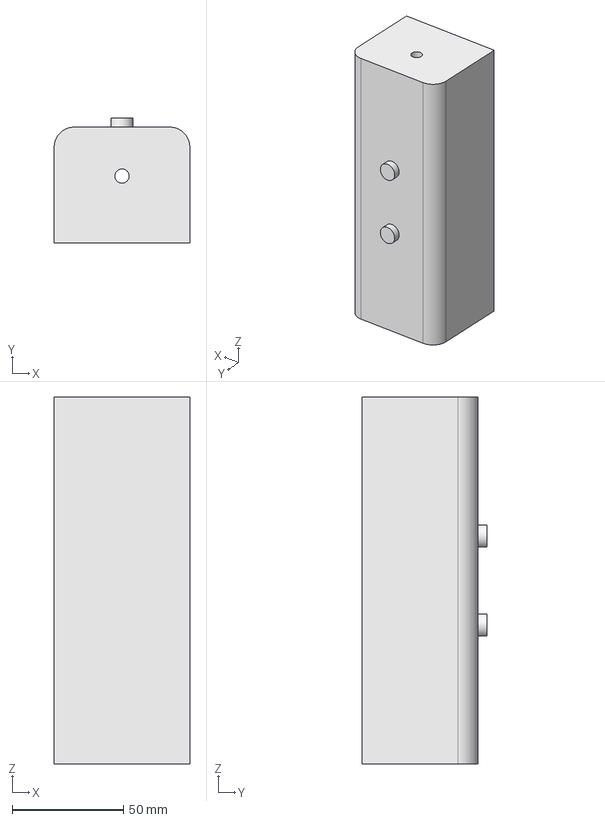
[picture p62: CAD file, 2025-04-12]
v2/step/Head-MoldMotor.step
61.0 x 56.0 x 165.0 mm
