kachurovskiy/modulathe/v2/freecad/Bed.FCStd

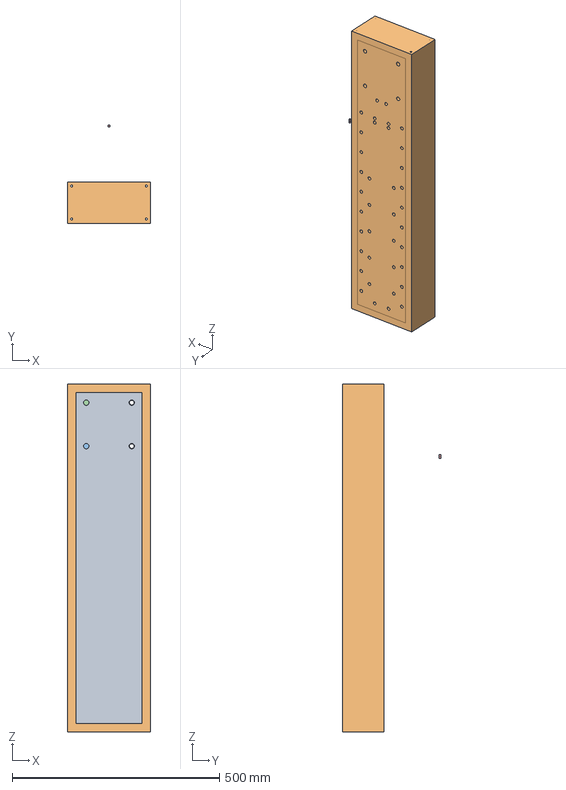
[picture p63: CAD file, 2025-04-12]
v2/freecad/Bed.FCStd
200.0 x 237.8 x 840.0 mm
Bed800
MoldTop800
Spoke
Spoke2
MoldConnector
