kachurovskiy/modulathe/v2/step/Head-MoldFront.step

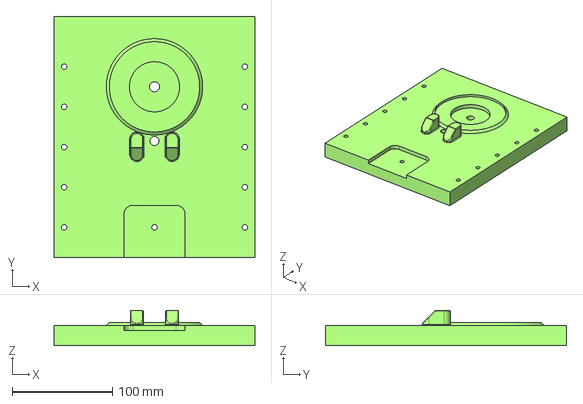
[picture p64: CAD file, 2025-04-12]
v2/step/Head-MoldFront.step
200.0 x 240.0 x 35.0 mm
