kachurovskiy/modulathe/v2/step/Bed-MoldConnector.step

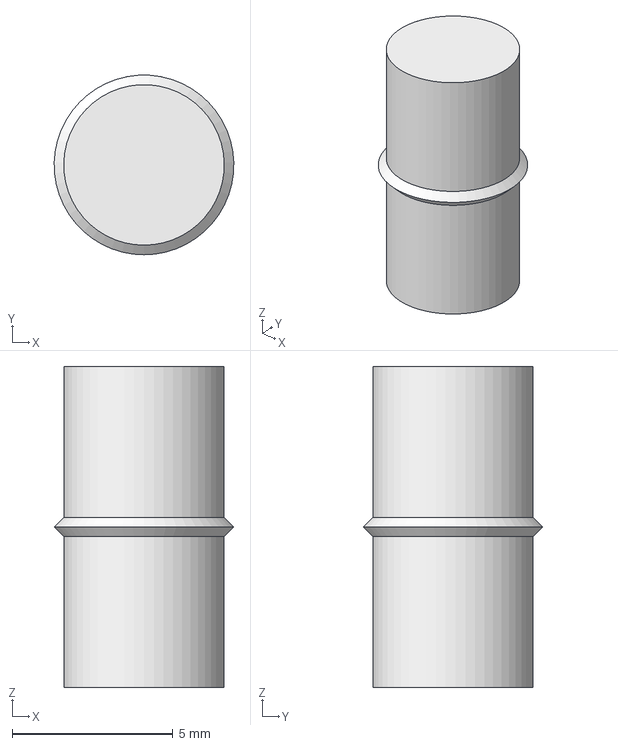
[picture p65: CAD file, 2025-04-12]
v2/step/Bed-MoldConnector.step
5.60 x 5.59 x 10.0 mm
