kachurovskiy/modulathe/v2/step/TailstockPlate-TailstockPlate.step

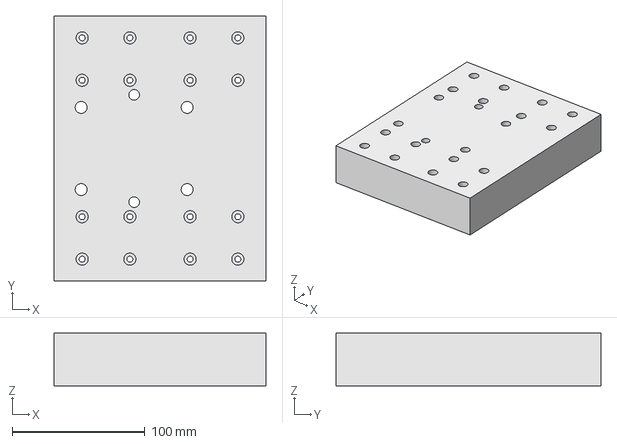
[picture p66: CAD file, 2025-04-12]
v2/step/TailstockPlate-TailstockPlate.step
160.0 x 200.0 x 40.0 mm
