kachurovskiy/modulathe/v2/step/Head-SpindleStop.step

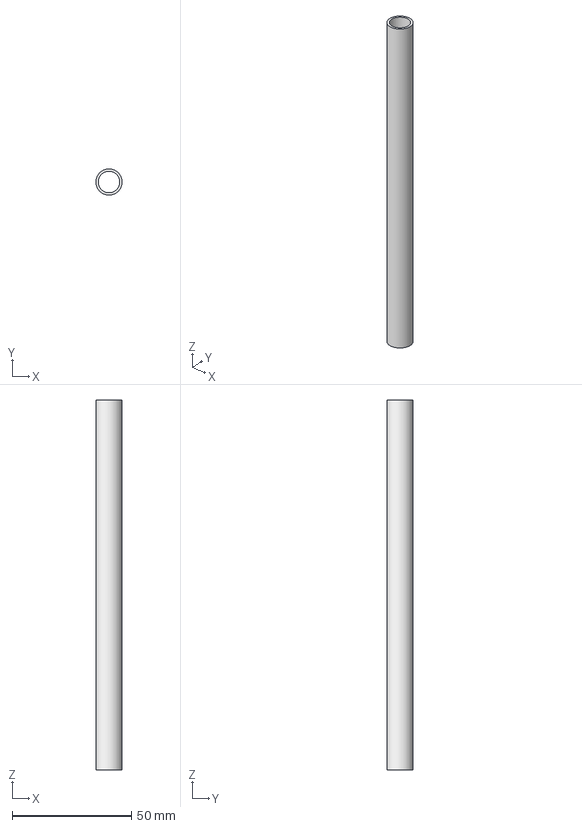
[picture p67: CAD file, 2025-04-12]
v2/step/Head-SpindleStop.step
11.0 x 11.0 x 155.0 mm
