kachurovskiy/modulathe/v2/step/Head-MoldBack.step

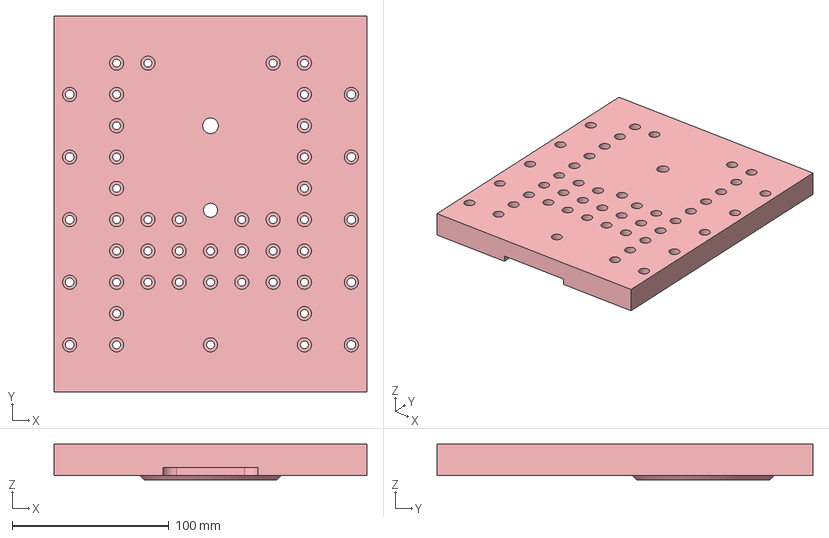
[picture p68: CAD file, 2025-04-12]
v2/step/Head-MoldBack.step
200.0 x 240.0 x 23.0 mm
