kachurovskiy/modulathe/v2/step/Bed-Bed800.step

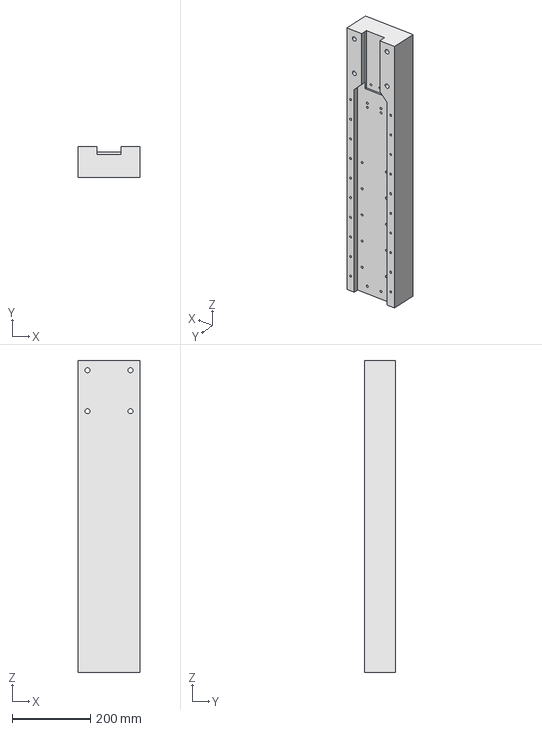
[picture p69: CAD file, 2025-04-12]
v2/step/Bed-Bed800.step
160.0 x 80.0 x 800.0 mm
