kachurovskiy/modulathe/v2/step/Head-Spider.step

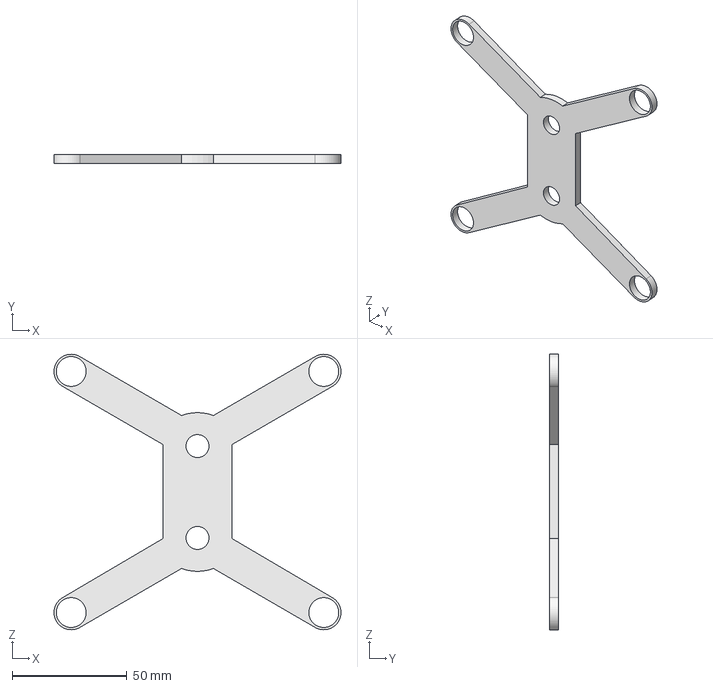
[picture p70: CAD file, 2025-04-12]
v2/step/Head-Spider.step
125.0 x 4.00 x 120.0 mm
