kachurovskiy/modulathe/v2/step/Head-StopHolder.step

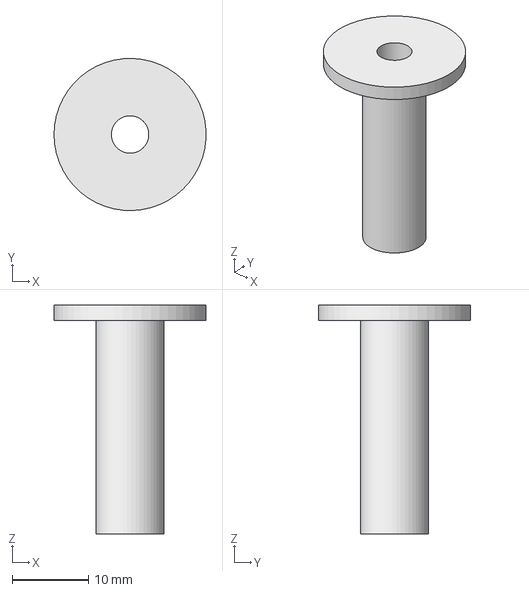
[picture p71: CAD file, 2025-04-12]
v2/step/Head-StopHolder.step
19.9 x 19.9 x 30.0 mm
