kachurovskiy/modulathe/v2/step/Bed-MoldTop800.step

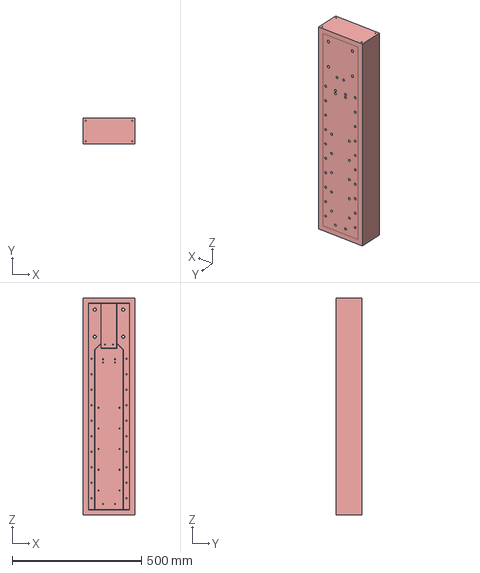
[picture p72: CAD file, 2025-04-12]
v2/step/Bed-MoldTop800.step
200.0 x 100.0 x 840.0 mm
