kachurovskiy/modulathe/v2/step/Head-Head.step

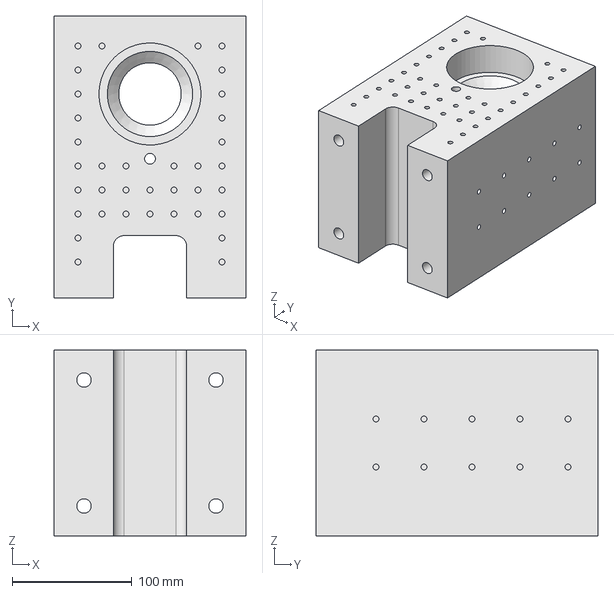
[picture p73: CAD file, 2025-04-12]
v2/step/Head-Head.step
160.0 x 235.0 x 155.0 mm
