kachurovskiy/modulathe/v2/step/Bed-Spoke.step

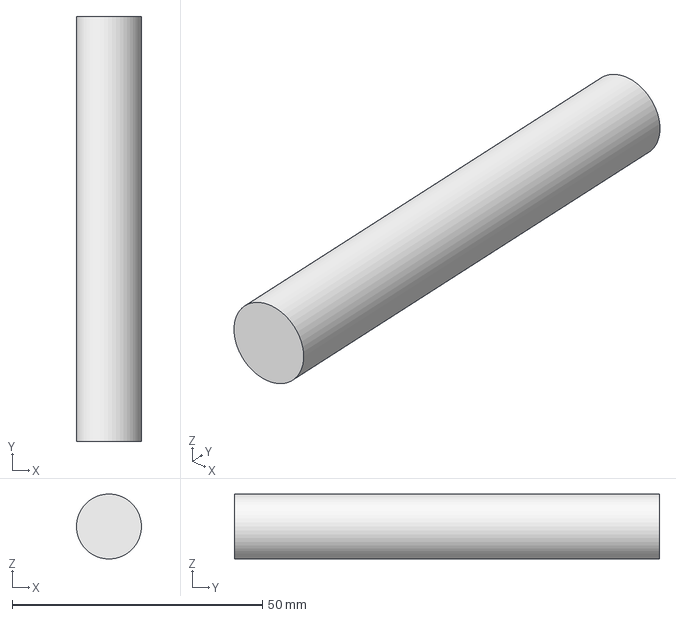
[picture p74: CAD file, 2025-03-24]
v2/step/Bed-Spoke.step
13.0 x 85.0 x 13.0 mm
