kachurovskiy/modulathe/v2/step/Head-FrontBearingPusher.step

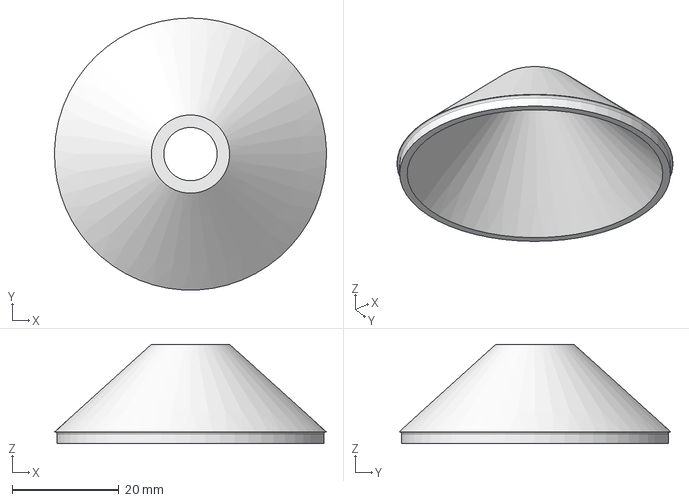
[picture p75: CAD file, 2025-03-24]
v2/step/Head-FrontBearingPusher.step
51.0 x 51.0 x 18.6 mm
