kachurovskiy/modulathe/v2/step/Head-MoldSide.step

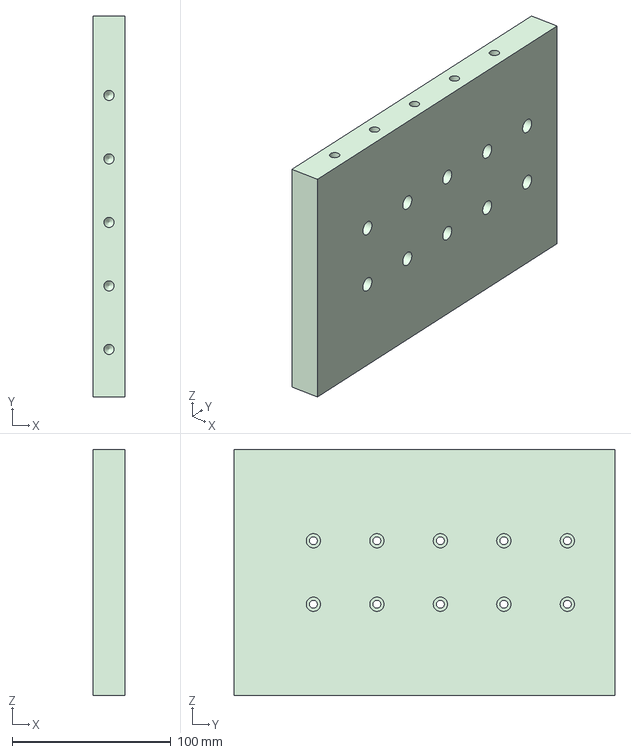
[picture p76: CAD file, 2025-03-24]
v2/step/Head-MoldSide.step
20.0 x 240.0 x 155.0 mm
