kachurovskiy/modulathe/v2/step/Head-MoldTop.step

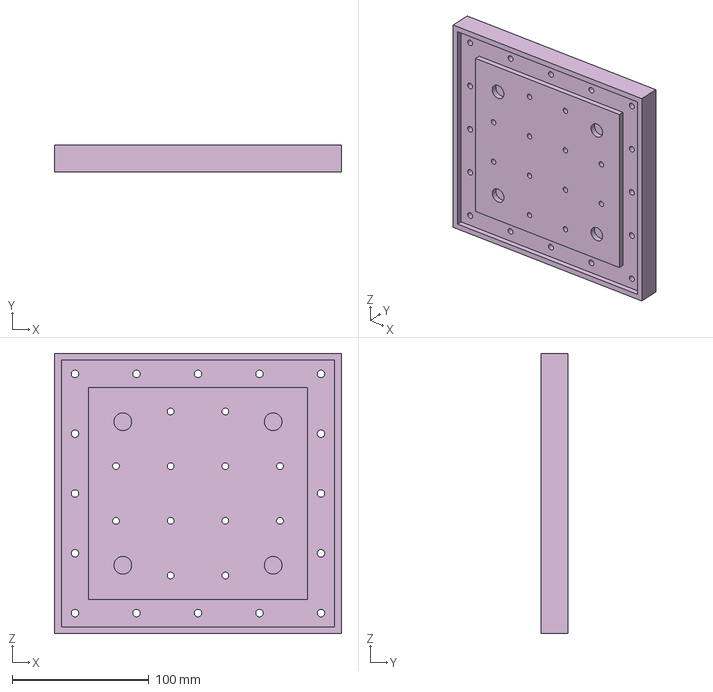
[picture p77: CAD file, 2025-03-24]
v2/step/Head-MoldTop.step
210.0 x 20.0 x 205.0 mm
