kachurovskiy/modulathe/v2/step/Head-DepthSpacer5.step

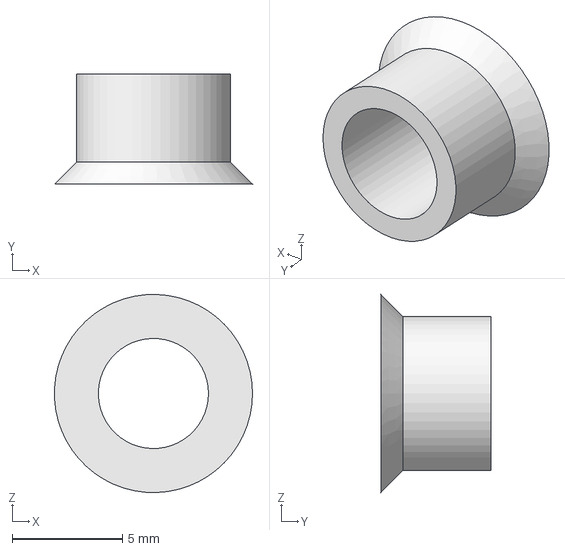
[picture p78: CAD file, 2025-03-10]
v2/step/Head-DepthSpacer5.step
8.99 x 5.00 x 9.00 mm
