kachurovskiy/modulathe/v2/step/Head-SpindleFront.step

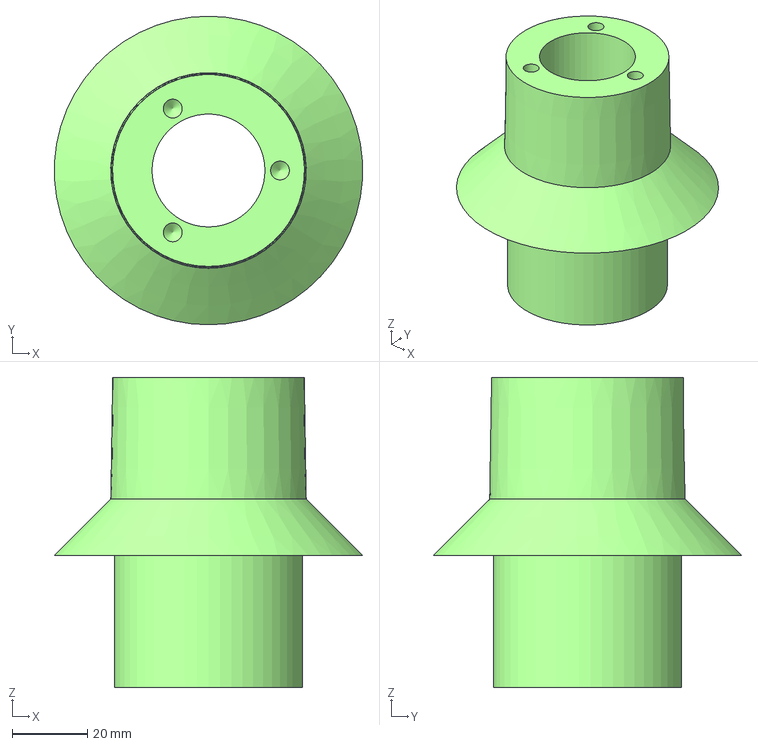
[picture p79: CAD file, 2025-03-02]
v2/step/Head-SpindleFront.step
81.9 x 82.0 x 82.5 mm
