kachurovskiy/modulathe/v2/step/Head-SpindleBack.step

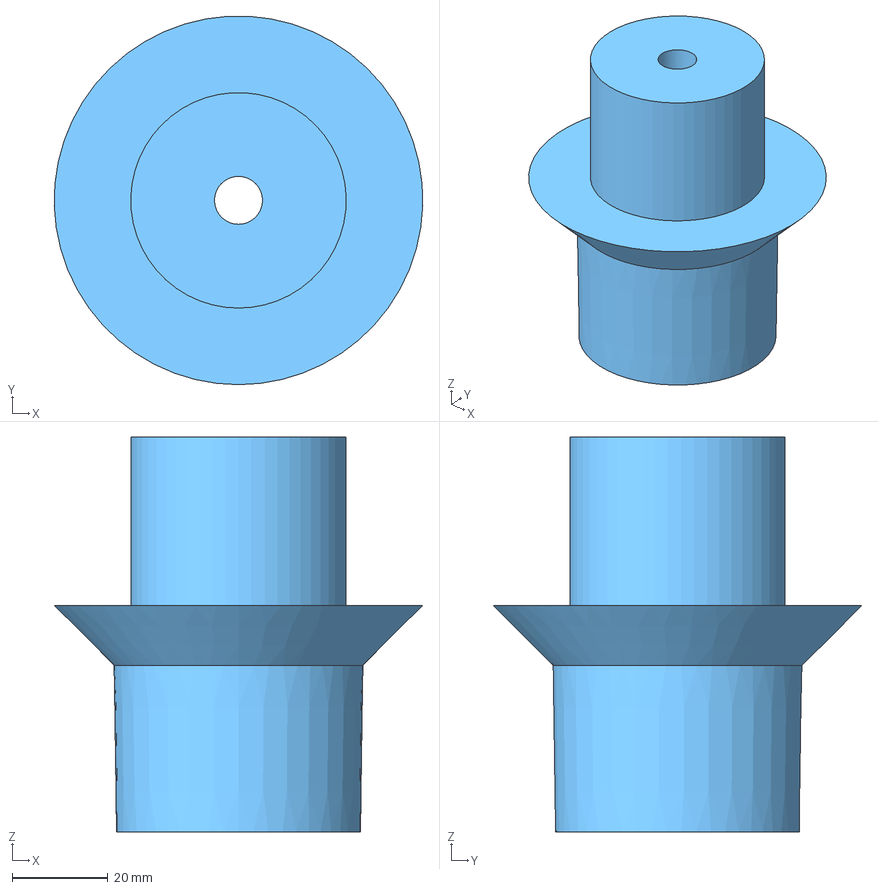
[picture p80: CAD file, 2025-03-02]
v2/step/Head-SpindleBack.step
77.0 x 76.9 x 82.5 mm
