kachurovskiy/modulathe/(list of files, cad)

Other CAD files:
v2/freecad/Assembly.FCStd
v2/step/Handwheel.step
v2/step/MiddlePlateGuard1.step
v2/step/TopPlateGuardLong2.step
v2/step/MotorPlate.step
v1/freecad/Assembly3DP.FCStd
v1/freecad/AssemblyCNC.FCStd
v1/freecad/BF10.FCStd
v1/freecad/BK10.FCStd
v1/freecad/BK10Axial.FCStd
v1/freecad/BallNutMount1204.FCStd
v1/freecad/BallNutMount2M5-3DP.FCStd
v1/freecad/BasePlateSmall.FCStd
v1/freecad/Bearing32009.FCStd
v1/freecad/Bearing32010.FCStd
v1/freecad/BearingPusher45-85.FCStd
v1/freecad/Bed.FCStd
v1/freecad/BedGuards.FCStd
v1/freecad/Block123-25-50-75.FCStd
v1/freecad/CL57T.FCStd
v1/freecad/CamBolt85.FCStd
v1/freecad/CenterlineFinder.FCStd
v1/freecad/Chuck125.FCStd
v1/freecad/Clamp20-60.FCStd
v1/freecad/Control1.FCStd
v1/freecad/Coupler10-8.FCStd
v1/freecad/DrillChuckMT2.FCStd
v1/freecad/EncoderGear30GT3.FCStd
v1/freecad/EncoderMount.FCStd
v1/freecad/EngineCover.FCStd
v1/freecad/H4MountHGH20.FCStd
v1/freecad/HGH15CA.FCStd
v1/freecad/HGH20CA.FCStd
v1/freecad/HGR15-500.FCStd
v1/freecad/HGW15CC.FCStd
v1/freecad/HM10-57-3DP.FCStd
v1/freecad/HM10-57.FCStd
v1/freecad/Handwheels.FCStd
v1/freecad/Headstock.FCStd
v1/freecad/HeadstockBack.FCStd
v1/freecad/HeadstockFront.FCStd
v1/freecad/HeadstockTop.FCStd
v1/freecad/M8Handle.FCStd
v1/freecad/MiddlePlate.FCStd
v1/freecad/MotorBelt9GT3.FCStd
v1/freecad/MotorPulley30GT3.FCStd
v1/freecad/NEMA23-113.FCStd
v1/freecad/NEMA23-136.FCStd
v1/freecad/NEMA34.FCStd
v1/freecad/Pipe160CrossFoot38M8.FCStd
v1/freecad/Pipe160x80Cap1.FCStd
v1/freecad/Pipe160x80x680.FCStd
v1/freecad/Power48V4A.FCStd
v1/freecad/RearBearingPusherM10-70mm.FCStd
v1/freecad/RearSupport.FCStd
v1/freecad/SFU1204-500.FCStd
v1/freecad/Spindle125-45.FCStd
v1/freecad/Spindle125-50-268.FCStd
v1/freecad/Spindle125-50-45.FCStd
v1/freecad/Spindle125-50.FCStd
v1/freecad/SpindleAligner38.FCStd
v1/freecad/SpindleComposite50.FCStd
v1/freecad/SpindleGear60GT3.FCStd
v1/freecad/SpindleLockNut45.FCStd
v1/freecad/SpindlePulleyCombo.FCStd
v1/freecad/SpindlePulleyGT3.FCStd
v1/freecad/StandPlate.FCStd
v1/freecad/TBolt80M8.FCStd
v1/freecad/TSlotNutM8.FCStd
v1/freecad/TailstockHolder.FCStd
v1/freecad/TailstockPlate.FCStd
v1/freecad/ToolHolder20.FCStd
v1/freecad/ToolPost40x40x50xM10.FCStd
v1/freecad/ToolPost60x80x50.FCStd
v1/freecad/ToolPost80x80x50.FCStd
v1/freecad/Toolpost60-60.FCStd
v1/freecad/Toolpost60-60CNC.FCStd
v1/freecad/TopPlate.FCStd
v1/freecad/Track30-400.FCStd
v1/freecad/ZMotorMount.FCStd
v1/step/BF10.step
v1/step/BK10Axial.step
v1/step/BearingPusher45.step
v1/step/BearingSupport61-89-10mm.step
v1/step/Bed680.step
v1/step/CenterlineFinder.step
v1/step/Control1Lid.step
v1/step/Control1MainBox.step
v1/step/EncoderGear30GT3.step
v1/step/EncoderMount.step
v1/step/EngineCover.step
v1/step/Guard1.step
v1/step/Guard2.step
v1/step/Guard3.step
v1/step/GuardSideRail.step
v1/step/H4MountArm.step
v1/step/H4MountBase.step
v1/step/HM10-57-3DP.step
v1/step/HeadstockConcrete125.step
v1/step/HeadstockConcreteSunk125.step
v1/step/M8Handle.step
v1/step/MiddlePlate3DP.step
v1/step/Motor1100BeltCover.step
v1/step/Motor1100Bracket.step
v1/step/MotorPulley30GT3.step
v1/step/Pipe160CrossFoot38M8.step
v1/step/Pipe160x80Cap1-NoHoles.step
v1/step/Pipe160x80Cap1.step
v1/step/PulseEncoderMount.step
v1/step/PulseHandwheel.step
v1/step/SpindleGear60GT3.step
v1/step/SpindleLockNut45.step
v1/step/TailstockCover.step
v1/step/TailstockHolder.step
v1/step/TailstockPlate-NoThreads.step
v1/step/ToolHolder20Cell.step
v1/step/Toolpost60-60.step
v1/step/Toolpost60-60CNC.step
v1/step/TopPlate-NoThreads.step
v1/step/ZMotorMount.step
v2/freecad/Cabinet.FCStd
v2/freecad/EncoderGearGT3-30.FCStd
v2/freecad/EncoderMount.FCStd
v2/freecad/EngineCover.FCStd
v2/freecad/M12Washer.FCStd
v2/freecad/M12x300.FCStd
v2/freecad/MiddlePlate.FCStd
v2/freecad/Motor1100Bracket.FCStd
v2/freecad/MotorPulley30GT3.FCStd
v2/freecad/RearStop.FCStd
v2/freecad/SpindleGear60GT3.FCStd
v2/freecad/TailstockPlate.FCStd
v2/freecad/Toolpost60Simple.FCStd
v2/freecad/TopPlate.FCStd
v2/step/HandwheelsMount.step
v2/step/Motor1100Bracket.stl
