kachurovskiy/modulathe/v1/step/MiddlePlate.pdf

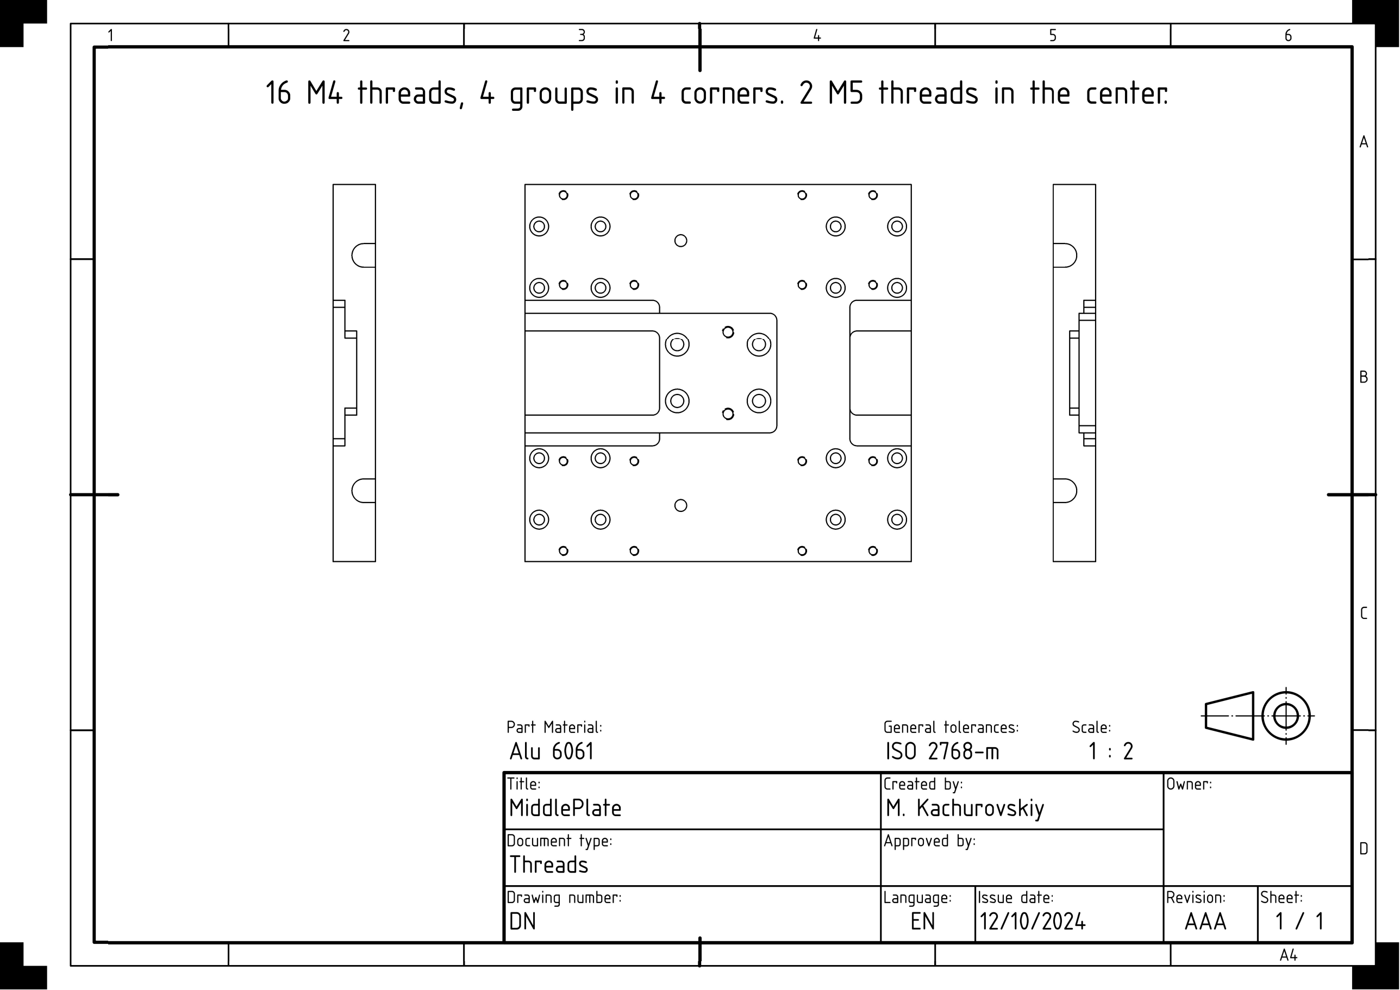
[picture p81: page 1]
