kachurovskiy/modulathe/(threads)

Thread 1 (2025-01-06):

structural profile instead of printing

kotovasia5120, 2025-01-06:
maybe it will be even cheaper than printing.
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
https://alumica.by/catalog/profil-dlya-stankov-bez-pokrytiya/alyuminievyy-konstruktsionnyy-profil-40kh141-paz-8-bez-pokrytiya/

kachurovskiy, 2025-01-07:
A very cool product but this is not available world-wide. AliExpress has some linear actuator profiles but they look somewhat different.

I guess the side slots can be used for the purpose of holding down the tailstock. 141mm width is smaller than 160mm we have but I guess it's fine. It's more expensive than printing but definitely nicer to work with.

kotovasia5120, 2025-01-08:
There is another one but it is even rarer
https://www.soberizavod.ru/catalog/konstruktsionnyy_profil_dlya_stankov/profil_konstruktsionnyy_dlya_stanka_60kh180_bez_pokrytiya/

Closed 2025-01-08.

Thread 2 (2025-01-23):

Aluminium profile fastening ideas

GeoGlobber, 2025-01-23:
Good day,

Thank you Maxim for opening up this fantastic project to us! I'd like to give building the modulathe a try, and also experimenting with the aluminium profile as a base. You mentioned that the alu base gives more fastening options. I've tried to come up with a basic design (although I'm not an engineer as you can see). Maybe you/anyone could give an opinion on it or have any advice?

The idea is to print attached guideways on the 3d base that can slide in the alu base rails. This is a tight printer fit for the headstock but should still work on the "standard" XY size 220mm build volume. In the most basic form it can be just these guideways, that are not printed undersize and are then ~~hammered~~ gently tapped into place in the alu base from one of the faces. Maybe epoxy is not even needed for combining the 3d bed together like this. Any lateral movement on the Z-axis can be prevented with end caps that can even be bolted to the faces of the alu base (those holes are M6 clearance and can be threaded).

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

One possible improvement over this design is adding "sliding nuts" like [this one](https://www.myaluprofil.de/Nutenstein-mit-Steg-Nut-8-M8-I-Typ.html) with an M8 thread:

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

Now gaps can be left in the 3d printed guideways to allow inserting one of these throughout the bed in multiple places. Then the bed can be bolted down in multiple places.

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

These can even work as connectors for keeping the 3d printed base parts together with rods like [these](https://www.myaluprofil.de/Profilstab-Laenge-500mm-rostfrei-Nut-8-I-Typ.html) (requires threading first of course):

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

The only thing is that the headstock bolt holes do not line up with the rails for this second version, although a headstock redesign is in order anyways to make it wider and fit axial bearings.

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

Let me know if any of this makes (mechanical) sense, and also your ideas on the topic 😃

Closed 2025-02-26.

Thread 6 (2025-07-15):

Consider documenting BoM with a focus on specs, using purchase links as e.gs

Ben-PH, 2025-07-15:
Awesome progress.

I have a concern that it will be a maintenance burden as links become dead. I've seen it happen with other projects.

Keep the links around, and perhaps include a link in the MD linking to an issue creation to facilitate community contribution for maintaining the links, but in my mind, an approach where items are _specified_, and links are just there as a shortcut, is more robust in the long term.

For example, with respect to the [other](https://github.com/kachurovskiy/modulathe/tree/master/v2#other-192-eur) list at time of writing:

instead of:

```md

### Other 192 EUR

- [10kg of PETG](https://www.ebay.de/itm/354057573174?var=624933263556) - 108 EUR
- [2 packs of M5 inserts 10mm length, outside diameter 7mm, 100Pcs](https://www.aliexpress.com/item/1005006798286851.html) - 15 EUR
- [Large 120 grit diamond plate](https://www.aliexpress.com/item/1005007177296408.html) - 10 EUR
- [Wet sandpaper 5pcs, 230x280mm, 240 grit](https://www.aliexpress.com/item/1005005510517824.html) - 6 EUR
- [4x rubber feet 38xM8x15mm](https://www.aliexpress.com/item/1005006179757754.html) - 7 EUR
- [Straight edge 300mm](https://www.aliexpress.com/item/4000846597491.html) - 34 EUR
- [Feeler gauge](https://www.aliexpress.com/item/1005007758368050.html) - 3 EUR
- [Bees wax](https://www.amazon.de/-/en/dp/B09QPRQ531) - 9 EUR
```

make it something like this

=========

| qty  | item                     | specs                   | appx price (Euro) | e.g. links (report broken link here)                  | extra notes                                         | Build reference                                             |
|------|--------------------------|-------------------------|-------------------|-------------------------------------------------------|-----------------------------------------------------|-------------------------------------------------------------|
| 10kg | PETG 3d printer filament |                         | 110               |                                                       |                                                     | - link to timestamp on YT - link to printing instructions   |
| 200  | heat-set inserts         | M5 len: 10mm, OD: 7mm   | 15                | https://www.aliexpress.com/item/1005007177296408.html | Maybe detail here something about performance reqs? | - link a reference that gives context of how they are used  |
| 1    | diamond lap-plate        | 100-140 grit, 200x160mm | 10                | https://www.aliexpress.com/item/1005005510517824.html |                                                     | - link to timestamp on YT                                   |
========

Ideally, each entry would have two purchase links, so that if one link dies, the second link can be referred to when finding a link to replace the broken one.

I'm happy to get started so that the boring work get's done, then you can extend the PR with comments/extra PR.

kachurovskiy, 2025-07-20:
Hi @Ben-PH, sorry for delay. Appreciate your input. I don't think we have much of a use case for tables here, just 3 pieces of data (description, price, link) one of which doesn't need to be explicitly spelled out (link) because it's meaning is in the remote content, not in the URI text. So with 2 pieces of data we can still use a list.

I don't think there's a use case to search for a row with a certain value (like e.g. in a threads table) so vertical alignment that a table brings is not needed.

Links go dead, when this happens I depend on the readers to report such cases or suggest fixes.

As you probably noticed, I favor simplicity over convention and this is one of those cases. Hope it helps. Thanks!

Closed 2025-07-20.
