kachurovskiy/modulathe/v2/step/MiddlePlate.pdf

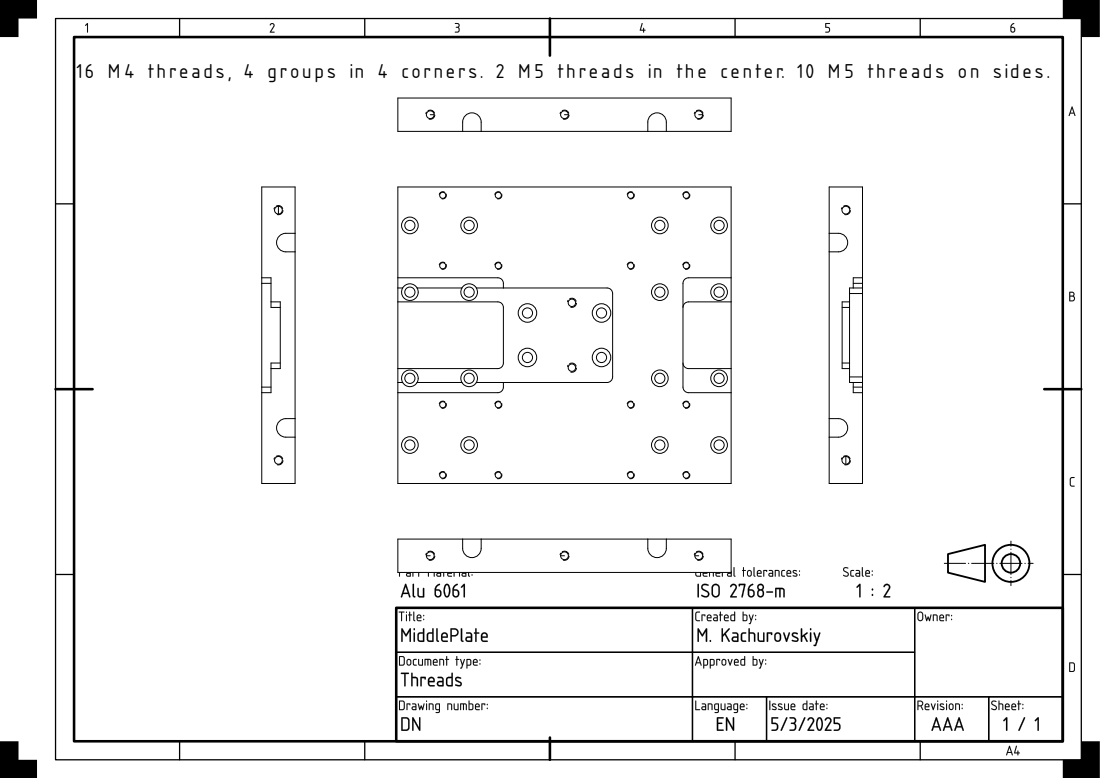
[picture p82: page 1]

16 M 4 threads, 4 groups in 4 corners. 2 M 5 threads in the center. 10 M 5 threads on sides.
