kachurovskiy/modulathe/v2/step/TailstockPlate.pdf

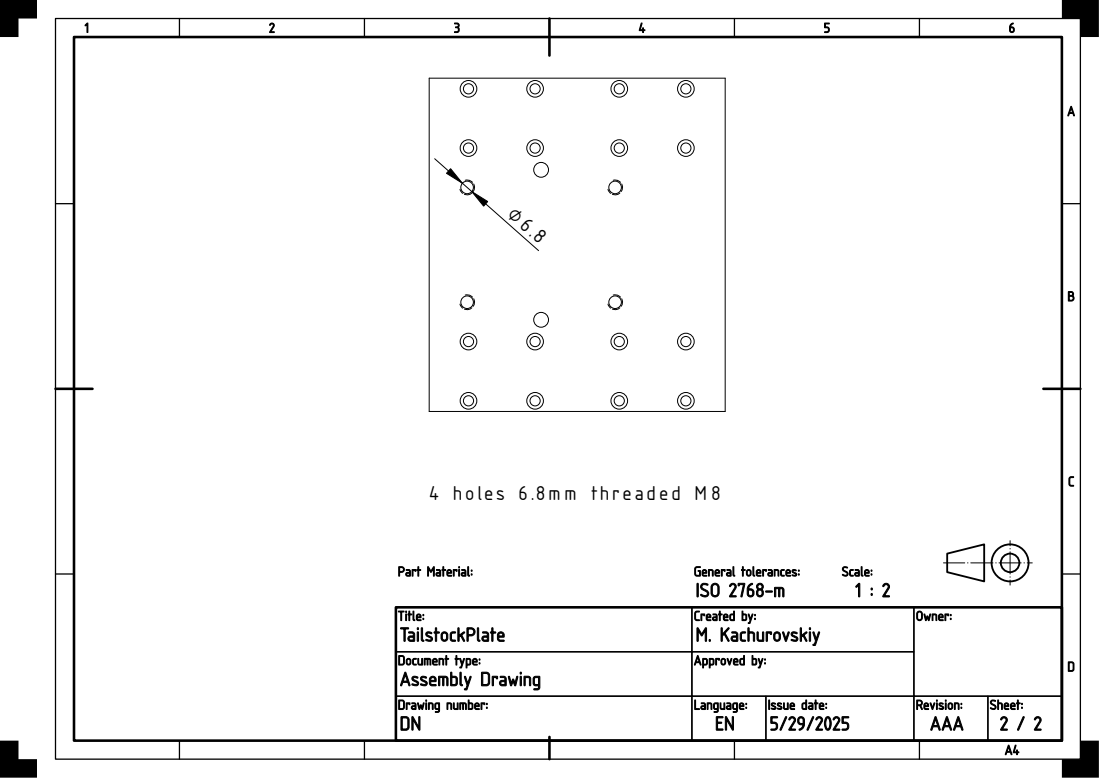
[picture p83: page 1]
4 holes 6.8 m m threaded M 8
