kachurovskiy/modulathe/v2/step/TopPlate.pdf

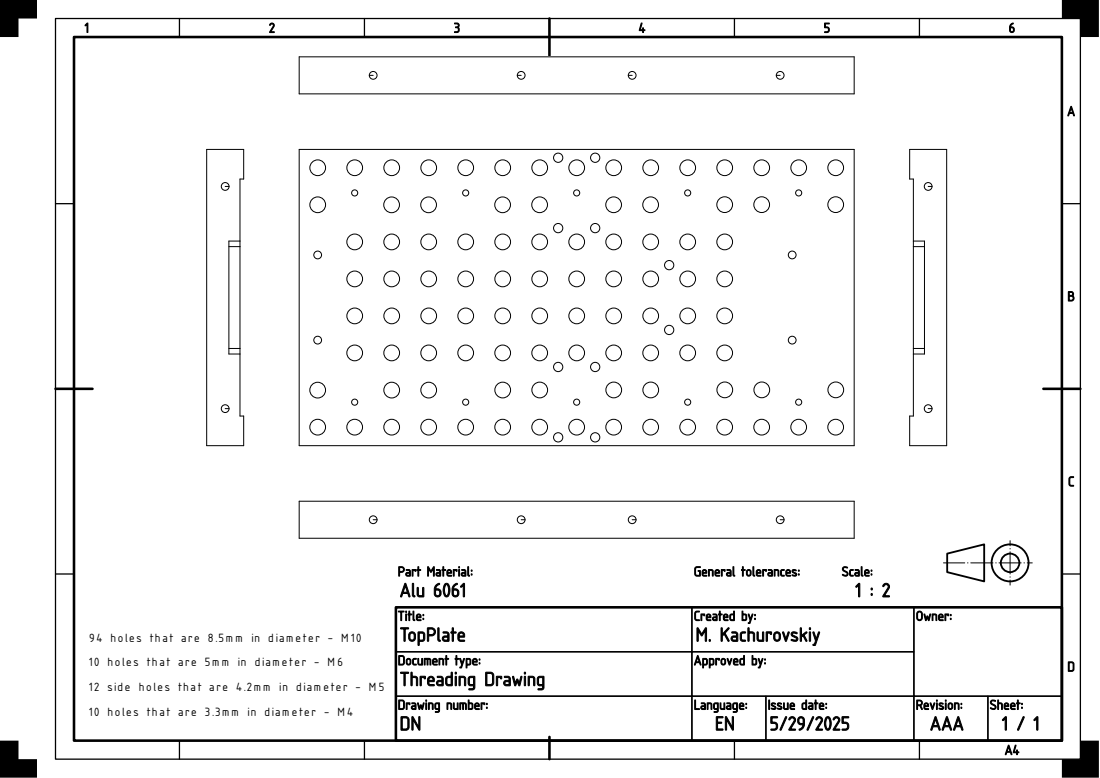
[picture p84: page 1]

94 holes that are 8.5m m in diam eter - M 10
10 holes that are 5m m in diam eter - M 6
12 side holes that are 4.2m m in diam eter - M 5
10 holes that are 3.3m m in diam eter - M 4
