kachurovskiy/modulathe/v2/step/Head-Plate.pdf

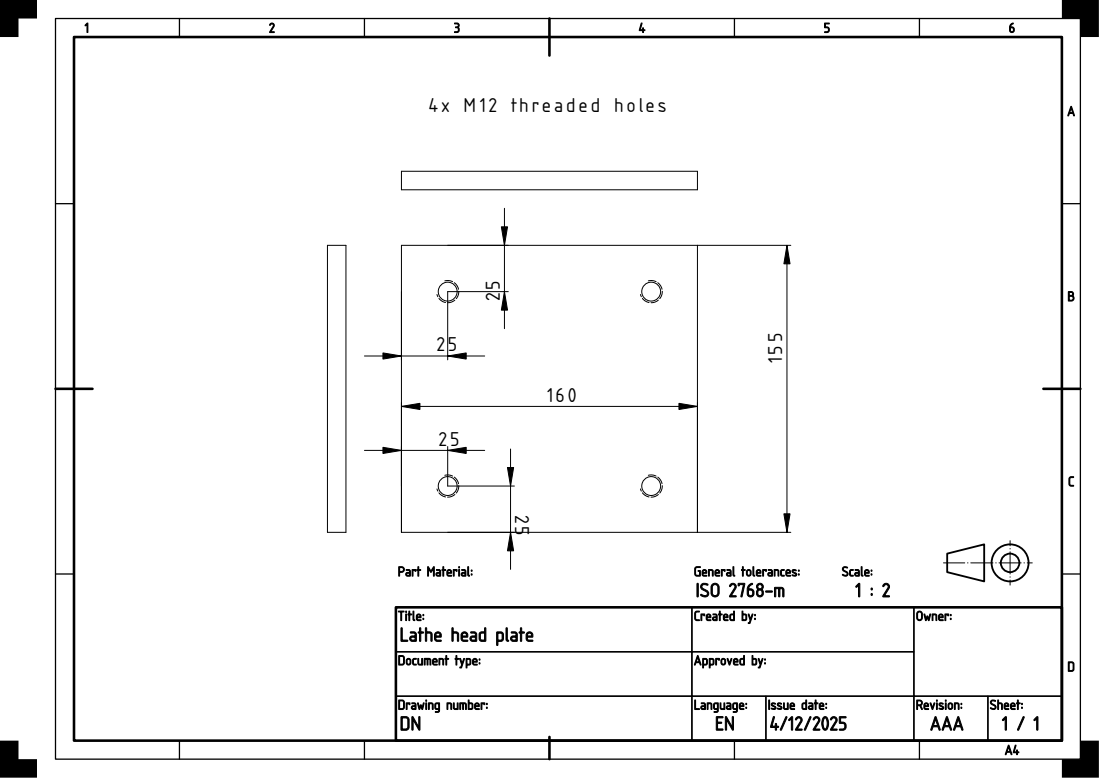
[picture p85: page 1]
4x M 12 threaded holes
