kachurovskiy/modulathe/v1/step/TopPlate.pdf

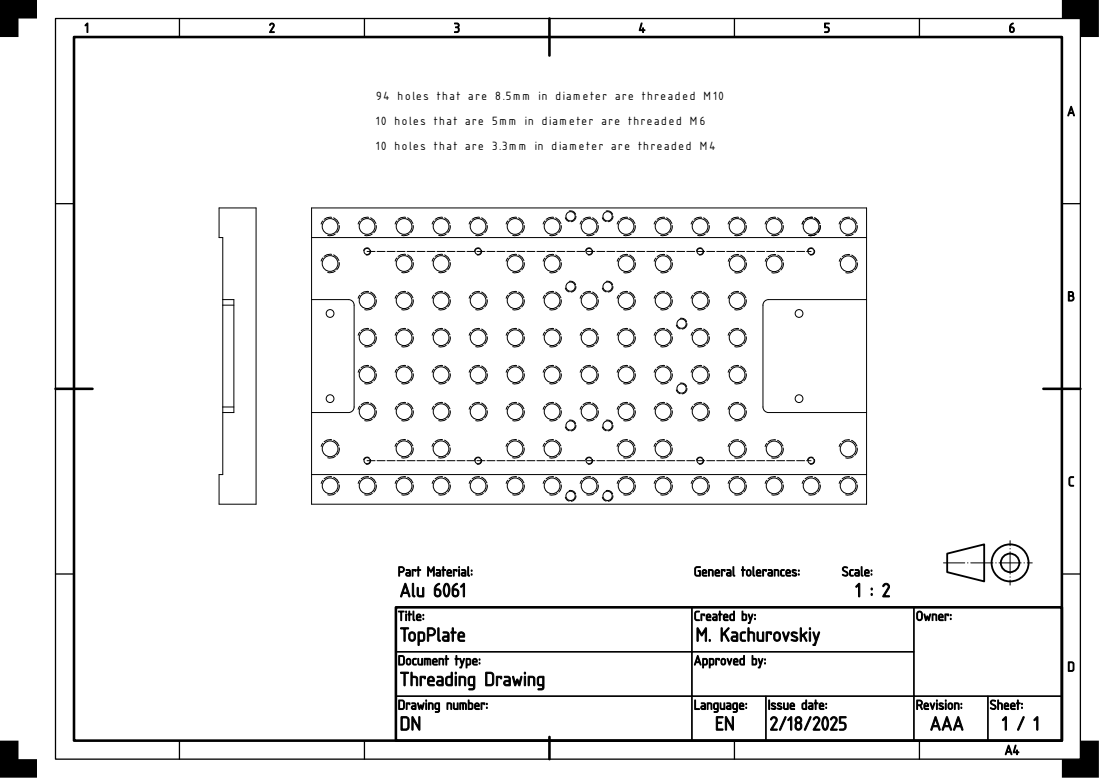
[picture p86: page 1]

94 holes that are 8.5m m in diam eter are threaded M 10
10 holes that are 5m m in diam eter are threaded M 6
10 holes that are 3.3m m in diam eter are threaded M 4
