kachurovskiy/modulathe/(commit log)

2024-09-09 Latest changes
    [ControlBox1.FCStd, FacePlate50-125mm.FCStd, ModuLathe-BasePlate-NoThreads.step, ModuLathe-BearingCover.step, ModuLathe-EncoderMount.step, ModuLathe-MiddlePlate-NoThreads.step, ModuLathe-MotorMount-WithThreads.step, ModuLathe-Pulley14mm-TB2.step]
2024-09-15 Minor changes
    [ModuLathe-BasePlate-NoThreads.step, ModuLathe-Toopost.step]
2024-09-26 Split into individual files, first assembly
    [Assembly1.FCStd, BasePlate.FCStd, Bearing32010.FCStd, Bearing32010Cover.FCStd, Clamp20-60.FCStd, Coupler10-8.FCStd, DrillChuckMT2.FCStd, DriverCase-Bottom.step]
2024-09-29 Continuation of the assembly, stand plate
    [Assembly1.FCStd, BF10Mini.FCStd, BK10.FCStd, BasePlate-140mm-NoThreads.step, BasePlate-Narrow-NoThreads.step, BasePlate.FCStd, Bearing32010Cover.FCStd, FacePlate50-125mm.FCStd]
2024-09-30 Rail alignment
    [Assembly1.FCStd, BF10Mini.FCStd, BK10.FCStd, BallNut1204.FCStd, BallNutMount1204.FCStd, BallNutMount2M5.FCStd, BasePlate.FCStd, Block123-25-50-75.FCStd]
2024-09-30 Fixes and tailstock base
    [Assembly1.FCStd, BK10.FCStd, BasePlate.FCStd, HM10-57.FCStd, HeadstockBack.FCStd, MiddlePlate.FCStd, NEMA23-136.FCStd, RearSupport.FCStd]
2024-10-05 Switching to an off-the-shelf spindle
    [Assembly1.FCStd, BasePlate.FCStd, Bearing32009.FCStd, HeadstockBack.FCStd, HeadstockFront.FCStd, RearSupport.FCStd, Spindle125-50-45.FCStd, SpindleComposite50.FCStd]
2024-10-05 T-slots for the tailstock
    [Assembly1.FCStd, BasePlate.FCStd, CamBolt85.FCStd, HeadstockFront.FCStd, MiddlePlate.FCStd, TBolt80M8.FCStd, TSlotNutM8.FCStd, TailstockPlate.FCStd]
2024-10-14 New motor and pulleys
    [Assembly1.FCStd, BF10.FCStd, BF10Mini.FCStd, BK10.FCStd, BallNut1204.FCStd, BallNutMount1204.FCStd, BallNutMount2M5.FCStd, BasePlate-140mm-NoThreads.step]
2024-10-16 Precise spindle dimensions, belts and pulleys
    [Assembly1.FCStd, EncoderBelt6GT3.FCStd, MotorBelt9GT3.FCStd, MotorPulley30GT3.FCStd, Spindle125-50-45.FCStd, SpindleGear60GT3.FCStd]
2024-10-23 3D-printable base
2024-11-04 Fixes, middle plate with threads
    [Assembly1.FCStd, MiddlePlate-NoThreads.step, MiddlePlate.FCStd, Motor1100Bracket.step, Tailstock100.FCStd, TopPlate-NoThreads.step, TopPlate.FCStd]
2024-11-26 Pipe base, 3D printed version improvements
    [Assembly1.FCStd, BF10Mini.step, BaseAndHeadstock3DP-MotorPlate.step, CL57T.FCStd, EncoderGear30GT3.step, EncoderMount.step, H4MountHGH20.FCStd, HGH20CA.FCStd]
2024-12-05 Control box, H4 mount, bed guards, rear covers
    [Assembly1.FCStd, BaseAndHeadstock3DP-MotorPlate.step, BaseAndHeadstock3DP-SandHoleCover.step, BaseAndHeadstock3DP-ThermometerHousingLIZ000009.step, BedGuards.FCStd, Control1.FCStd, Control1Lid.step, Control1MainBox.step]
2024-12-06 3dp assembly, guard rail magnets, control box and cover adjustments, tool holder
    [Assembly1.FCStd, Assembly3DP.FCStd, AssemblyCNC.FCStd, BF10.FCStd, BF10Mini.FCStd, BK10.FCStd, BallNut1204.FCStd, BallNutMount1204.FCStd]
2024-12-07 Moving model files to a folder, spindle lock
    [Assembly3DP.FCStd, AssemblyCNC.FCStd, BF10.FCStd, BF10Mini.FCStd, BK10.FCStd, BallNut1204.FCStd, BallNutMount1204.FCStd, BallNutMount2M5.FCStd]
2024-12-08 Alu t-tracks, holes for inserts, 500 ball screw
    [Assembly3DP.FCStd, BF10.FCStd, BF10Mini.FCStd, BaseAndHeadstock3DP.FCStd, BaseAndHeadstock3DP.step, Control1Lid.step, Control1MainBox.step, SFU1204-500.FCStd]
2024-12-08 Bearing pusher 45
    [BearingPusher45-75.FCStd, BearingPusher45.step]
2024-12-26 Bed flatness aligners, rail spacers, middle plate magnets, axial ball screw mounts
    [Assembly3DP.FCStd, BK10Axial.FCStd, BK10Axial.step, BallNutMount2M5-3DP.FCStd, BaseAndHeadstock3DP.FCStd, BaseAndHeadstock3DP.step, BedGuards.FCStd, Guard1.step]
2025-01-15 Better Z motor plate, assembly helpers, middle plate thread inserts
    [BF10.FCStd, BF10.step, BaseAndHeadstock3DP-MotorPlate.step, BaseAndHeadstock3DP-SandHoleCover.step, BaseAndHeadstock3DP-ThermometerHousingLIZ000009.step, BaseAndHeadstock3DP.FCStd, BaseAndHeadstock3DP.step, BearingPusher45-75.FCStd]
2025-01-18 Side guard for the carriage
    [BedGuards.FCStd, Guard1.step, SideGuard1.step]
2025-01-18 Minor ball screw mount improvements
    [BF10.FCStd, BF10.step, HM10-57-3DP.FCStd, HM10-57-3DP.step]
2025-02-17 Tailstock and improved concrete headstock
    [Assembly3DP.FCStd, BF10.FCStd, BF10.step, BaseAndHeadstock3DP-NoPlate.step, BaseAndHeadstock3DP-NoSandHole.step, BaseAndHeadstock3DP.FCStd, CenterlineFinder.FCStd, CenterlineFinder.step]
2025-02-17 Sunk nuts on the headstock
    [Headstock.FCStd, HeadstockConcreteSunk125.step]
2025-02-18 Simplify head and bed models
    [Assembly3DP.FCStd, BF10Mini.step, BaseAndHeadstock3DP-NoPlate.step, BaseAndHeadstock3DP-NoSandHole.step, BaseAndHeadstock3DP-SandHoleCover.step, BaseAndHeadstock3DP.FCStd, BaseAndHeadstock3DP.step, BasePlate.FCStd]
2025-02-18 Specify M6 threads for the top plate access holes to be able to plug them with grub screws
    [TopPlate.FCStd]
2025-02-20 Tailstock adjustements
    [3209B-2RS.FCStd, 3210B-2RS.FCStd, Assembly.FCStd, Assembly3DP.FCStd, BF12.FCStd, BK12Axial.FCStd, Bed.FCStd, Coupler25-20-8-10.FCStd]
2025-02-27 v2 head mold
    [3209B-2RS.FCStd, 3210B-2RS.FCStd, Assembly.FCStd, Bed.FCStd, Encoder38-6.FCStd, EncoderBelt6GT3.FCStd, EncoderGearGT3-30.FCStd, EncoderMount.FCStd]
2025-02-28 Prevent head mold bulging
    [Head-Chute.step, Head-Head.step, Head-MoldBack.step, Head-MoldBottom.step, Head-MoldFront.step, Head-MoldMotor.step, Head-MoldSide.step, Head-MoldSpoke.step]
2025-03-02 v2 upside-down head mold using bearings
    [Assembly.FCStd, Bed.FCStd, Head-Chute.step, Head-MoldBack.step, Head-MoldBottom.step, Head-MoldFront.step, Head-MoldMotor.step, Head-MoldSide.step]
2025-03-10 Head final updates and bed all-printed mold
    [Assembly.FCStd, Bed-MoldBottom.step, Bed-MoldCross.step, Bed-MoldTop800.step, Bed.FCStd, Head-DepthSpacer5.step, Head-Head.step, Head-MoldFront.step]
2025-03-15 v2 bed mold updates
    [Bed-M12Spacer.step, Bed-MoldBottom.step, Bed-MoldCrossM8.step, Bed.FCStd]
2025-03-24 Another iteration on head, bed and tailstock molds
    [Assembly.FCStd, BF10.FCStd, BF12.FCStd, BK12C5.FCStd, BallNut1204.FCStd, BallNutMount2M5.FCStd, Bed-M12Spacer.step, Bed-MoldBottom.step]
2025-04-12 Latest molds, wider tailstock plate
    [Assembly.FCStd, Bed-Bed800.step, Bed-MoldConnector.step, Bed-MoldTop800.step, Bed.FCStd, HGH20CA.FCStd, Head-Head.step, Head-MoldBack.step]
2025-07-10 Latest updates
    [Assembly.FCStd, BallNutMount2M5.FCStd, HM10-57.FCStd, MiddlePlate.FCStd, MiddlePlate.step, Motor1100Bracket.FCStd, Motor1100w.FCStd, MotorPlate.step]
2025-07-14 Add v2 bill of materials
2025-09-17 Guards, cabinet, handwheels
    [3209B-2RS.FCStd, 3210B-2RS.FCStd, Assembly.FCStd, BF10.FCStd, BF12.FCStd, BK12Axial.FCStd, BK12C5.FCStd, BallNut1204.FCStd]
2025-10-27 Mold removal
2025-12-15 Enhance README with post-processing and installation steps
    Added detailed instructions for post-processing castings, bed flattening, and installation of bed rails, bearings, and spindle.
2026-01-20 Mention grub screws in v2 docs
